FyrBridd/ext_trigger_jbl_sa550/docs/superpowers/plans/2026-11-10-hardware.md

# Dongle Hardware (tooling, schematic, board, fabrication files) Implementation Plan

> **For agentic workers:** REQUIRED SUB-SKILL: Use superpowers:subagent-driven-development (recommended) or superpowers:executing-plans to implement this plan task-by-task. Steps use checkbox (`- [ ]`) syntax for tracking.

**Goal:** Produce a checked KiCad 10 project and JLCPCB fabrication files for the WiiM-trigger-to-RS232 dongle board, entirely from the headless box.

**Architecture:** One Python file (`circuit.py`) is the single source of truth for parts and nets. Scripts generate the schematic (kicad-sch-api) and the board (KiCad's `pcbnew` Python module) from it; nobody hand-writes KiCad file syntax. Every stage is gated by `kicad-cli` checks run through pytest. All tools run in one Docker container.

**Tech Stack:** Docker, `kicad/kicad:10.0` image (KiCad 10.0.8, Python 3.13, `pcbnew`), kicad-sch-api 0.5.5, pytest, `kicad-cli`.

**Spec:** `docs/superpowers/specs/2026-11-10-wiim-trigger-jbl-dongle-design.md` (sections 5, 6, 9 and 10 are the ones this plan implements). Read it before starting.

**Companion plans:** `2026-11-10-firmware.md` (needs only Task 1 of this plan). The enclosure gets its own plan after this one finishes, because it needs the board's 3D model and the owner's cable measurements.

## Global Constraints

- All commands run through `tools/dev <command>` (Task 1). The box has no passwordless sudo; never use sudo.
- KiCad project files under `hardware/dongle/` are generated. Never edit them by hand; change `circuit.py`, `layout.py` or a generator and regenerate.
- Board: 2 layers, 1.6 mm, every assembled part on the top side, ground pour on the bottom.
- Outline: target 12 × 38 mm; hard limits width ≤ 14 mm, length ≤ 45 mm, each side ≥ 10 mm.
- Assembled parts ≥ 1.0 mm from the board edge. Passives are 0603, except the two 10 µF capacitors (0805). Nothing smaller.
- Parts and LCSC numbers exactly as the spec's section 6 table (R1 is 100 Ω, C22775).
- U2 pin 6 (PA0/UPDI) connects only to the programming footprint pad 4 and one test pad.
- Programming footprint pads 1, 5 and 6 are unconnected.
- Every review document is a PDF or Markdown file in the repository; the owner must be able to review the whole design without opening KiCad.
- Done means: ERC zero errors; exported netlist equals `circuit.py`; DRC zero errors, zero unconnected items, schematic parity clean; stock gate passes.
- Commit after each task with the message given. Commit messages end with the line `Co-Authored-By: Claude Fable 5.2 <noreply@anthropic.com>`.

## Review Focus

Failure modes the spec implies that are most likely to cost a board respin:

1. A symbol pin number that does not match the real part's pin (HT7533 pin order, SP3232 charge-pump pins, diode polarity). Pinned by Task 5 (independent datasheet review) and `test_pin_functions` in Task 2.
2. Schematic and board silently disagreeing. Pinned by the netlist-equality test (Task 4) and DRC schematic parity (Task 7).
3. Programming footprint pads in the wrong physical order for the TC2030-MCP-NL cable. Pinned by Task 3's datasheet check and `test_tc2030_pad_positions`.
4. A part placed by JLCPCB rotated 180° (SOT-89, SOIC, TSSOP, diodes). Pinned by `test_cpl_rotations` in Task 8 and the owner's check of JLCPCB's placement preview (Task 10).
5. Wire pads or strain-relief holes too close to the edge or to each other to survive soldering. Pinned by `test_wire_pad_geometry` in Task 3 and `test_edge_clearance` in Task 6.

---

## File structure

```
tools/Dockerfile               dev image: KiCad 10 + Python venv + AVR and host compilers
tools/dev                      wrapper that builds the image if needed and runs a command in it
tools/jlc_stock.py             stock gate (Task 9)
tools/tests/                   pytest for tools
Makefile                       top-level shortcuts
hardware/design/circuit.py     parts and nets: the source of truth
hardware/design/gen_footprints.py  writes the custom footprints
hardware/design/gen_sch.py     circuit.py -> hardware/dongle/dongle.kicad_sch
hardware/design/layout.py      outline, placements, tracks, vias, zones (data only)
hardware/design/gen_pcb.py     circuit.py + layout.py -> hardware/dongle/dongle.kicad_pcb
hardware/design/kicad.py       thin helpers that call kicad-cli and parse its JSON
hardware/design/export_fab.py  Gerbers, drill, BOM, CPL, STEP, renders, PDF
hardware/lib/dongle.pretty/    generated custom footprints
hardware/lib/README.md         datasheet evidence for footprints and pinouts
hardware/dongle/               generated KiCad project (committed)
hardware/fab/                  generated fabrication outputs (committed)
hardware/tests/                pytest for all of the above
docs/hardware-review.md        owner's review pack and ordering steps (Task 10)
```

---

### Task 1: Dev container and repository skeleton

**Files:**
- Create: `tools/Dockerfile`, `tools/dev`, `Makefile`, `.gitignore`, `README.md`, `tools/tests/test_env.py`

**Interfaces:**
- Produces: `tools/dev <cmd...>` runs `<cmd>` inside the image with the repo mounted at `/work` (the working directory), as the caller's uid, with `HOME=/tmp/home`. Image name `dongle-dev`. Inside it: `kicad-cli`, `python` (venv with `pcbnew`, `kicad_sch_api`, `pytest`), `avr-gcc`, `avr-objcopy`, `avr-size`, `gcc`, `make`.

- [ ] **Step 1: Write the failing test** `tools/tests/test_env.py`

```python
import subprocess, shutil

def run(*a): return subprocess.run(a, capture_output=True, text=True, check=True).stdout

def test_kicad_cli_is_10():
    assert run("kicad-cli", "version").strip().startswith("10.0.")

def test_python_modules():
    import pcbnew, kicad_sch_api
    assert pcbnew.Version().startswith("10.0.")
    assert kicad_sch_api.__version__ == "0.5.5"

def test_avr_gcc_knows_attiny412(tmp_path):
    src = tmp_path / "m.c"; src.write_text("#include <avr/io.h>\nint main(void){PORTA.DIRSET=PIN3_bm;for(;;){}}\n")
    run("avr-gcc", "-mmcu=attiny412", "-Os", "-o", str(tmp_path / "m.elf"), str(src))

def test_host_gcc_and_make():
    assert shutil.which("gcc") and shutil.which("make")
```

- [ ] **Step 2: Write `tools/Dockerfile`**

```dockerfile
FROM kicad/kicad:10.0
USER root
RUN apt-get update && apt-get install -y --no-install-recommends \
      python3-pip python3-venv gcc libc6-dev make gcc-avr avr-libc binutils-avr \
    && rm -rf /var/lib/apt/lists/*
RUN python3 -m venv --system-site-packages /opt/venv \
    && /opt/venv/bin/pip install --no-cache-dir kicad-sch-api==0.5.5 pytest
ENV PATH=/opt/venv/bin:$PATH
```

- [ ] **Step 3: Write `tools/dev`** (bash, executable). It runs `docker build -q -t dongle-dev tools/` (cached), then `docker run --rm -u "$(id -u):$(id -g)" -e HOME=/tmp/home -v "<repo root>":/work -w /work dongle-dev "$@"`. Do not use a login shell inside the container; it resets `PATH` and hides the venv.

- [ ] **Step 4: Write `.gitignore`** (`__pycache__/`, `.pytest_cache/`, `*.elf`, `*.o`, `firmware/build/`, `hardware/dongle/*-backups/`, `hardware/dongle/*.lck`, `fp-info-cache`), a `Makefile` with targets `env-test` (`tools/dev pytest tools/tests -q`) and `hw-test` (`tools/dev pytest hardware/tests -q`), and a `README.md` of a few lines: what the project is, a link to the spec, and "run everything through `tools/dev`".

- [ ] **Step 5: Run the test**

Run: `tools/dev pytest tools/tests/test_env.py -q`
Expected: 4 passed. If `test_avr_gcc_knows_attiny412` fails because the image's avr-libc lacks the ATtiny412, stop and report; the fix (a Microchip device pack) needs a decision.

- [ ] **Step 6: Commit** — `chore: dev container and repo skeleton`

---

### Task 2: Circuit definition

**Files:**
- Create: `hardware/design/circuit.py`, `hardware/design/__init__.py`, `hardware/tests/test_circuit.py`

**Interfaces:**
- Produces:
  - `Part` dataclass: `ref: str, value: str, symbol: str, footprint: str, lcsc: str | None, assemble: bool`.
  - `PARTS: dict[str, Part]` keyed by ref.
  - `NETS: dict[str, list[tuple[str, str]]]` mapping net name to `(ref, pin_number)` pairs.
  - `NO_CONNECT: list[tuple[str, str]]`.
  - `PIN_FUNCTIONS: dict[tuple[str, str], str]` giving the datasheet function of every IC pin, for review.

Parts (symbol libraries are KiCad's stock ones; `dongle:` footprints come from Task 3):

| Ref | Value | Symbol | Footprint | LCSC | Assemble |
|---|---|---|---|---|---|
| U1 | HT7533-1 | `Regulator_Linear:HT75xx-1-SOT89` | `Package_TO_SOT_SMD:SOT-89-3` | C14289 | yes |
| U2 | ATtiny412-SSNR | `MCU_Microchip_ATtiny:ATtiny412-SS` | `Package_SO:SOIC-8_3.9x4.9mm_P1.27mm` | C1337190 | yes |
| U3 | SP3232EEY | `Interface_UART:MAX3232` | `Package_SO:TSSOP-16_4.4x5mm_P0.65mm` | C13482 | yes |
| D1 | B5819W | `Device:D_Schottky` | `Diode_SMD:D_SOD-123` | C8598 | yes |
| D2 | SMF15CA | `Device:D_TVS` | `Diode_SMD:D_SOD-123F` | C19077510 | yes |
| D3 | RED | `Device:LED` | `LED_SMD:LED_0603_1608Metric` | C2286 | yes |
| C1, C2 | 10u 25V | `Device:C` | `Capacitor_SMD:C_0805_2012Metric` | C15850 | yes |
| C3–C8 | 100n 50V | `Device:C` | `Capacitor_SMD:C_0603_1608Metric` | C14663 | yes |
| R1 | 100R | `Device:R` | `Resistor_SMD:R_0603_1608Metric` | C22775 | yes |
| R2 | 1k | `Device:R` | same | C21190 | yes |
| R3 | 10k | `Device:R` | same | C25804 | yes |
| J1 | TRIGGER | `Connector_Generic:Conn_01x02` | `dongle:WirePads_1x02_Strain` | — | no |
| J2 | RS232 | `Connector_Generic:Conn_01x03` | `dongle:WirePads_1x03_Strain` | — | no |
| J3 | TC2030 | `Connector_Generic:Conn_01x06` | `dongle:TC2030-MCP-NL` | — | no |
| TP1–TP8 | see nets | `Connector:TestPoint` | `TestPoint:TestPoint_Pad_D1.0mm` | — | no |

Nets (pin numbers are package pin numbers):

| Net | Pins |
|---|---|
| `TRIG_IN` | J1.1, R1.1 |
| `TRIG_R` | R1.2, D2.1, D1.2 (anode) |
| `VIN` | D1.1 (cathode), C1.1, U1.2, TP1.1 |
| `+3V3` | U1.3, C2.1, C3.1, U2.1, U3.16, C8.1, R3.1, J3.2, TP2.1 |
| `GND` | J1.2, D2.2, C1.2, U1.1, C2.2, C3.2, U2.8, U3.15, U3.10, C8.2, C6.2, C7.1, D3.1 (cathode), J2.3, J3.3, TP3.1 |
| `UART_TX` | U2.2, U3.11, R3.2, TP4.1 |
| `UART_RX` | U2.3, U3.12, TP5.1 |
| `RS232_TX` | U3.14, J2.1 |
| `RS232_RX` | U3.13, J2.2 |
| `UPDI` | U2.6, J3.4, TP6.1 |
| `DBG` | U2.4, TP7.1 |
| `SPARE` | U2.5, TP8.1 |
| `LED_DRV` | U2.7, R2.1 |
| `LED_A` | R2.2, D3.2 (anode) |
| `C1P` / `C1M` | U3.1, C4.1 / U3.3, C4.2 |
| `C2P` / `C2M` | U3.4, C5.1 / U3.5, C5.2 |
| `VPOS` | U3.2, C6.1 |
| `VNEG` | U3.6, C7.2 |

`NO_CONNECT`: U3.7, U3.8, U3.9, J3.1, J3.5, J3.6.

- [ ] **Step 1: Write the failing tests** in `hardware/tests/test_circuit.py`

```python
from hardware.design import circuit as c

SPEC_LCSC = {"U1":"C14289","U2":"C1337190","U3":"C13482","D1":"C8598","D2":"C19077510",
             "D3":"C2286","C1":"C15850","C2":"C15850","R1":"C22775","R2":"C21190","R3":"C25804",
             **{f"C{i}":"C14663" for i in range(3, 9)}}

def all_pins(): return [p for pins in c.NETS.values() for p in pins]

def test_lcsc_numbers_match_spec():
    assert {r: p.lcsc for r, p in c.PARTS.items() if p.assemble} == SPEC_LCSC

def test_unassembled_parts_have_no_lcsc():
    assert all(p.lcsc is None for p in c.PARTS.values() if not p.assemble)

def test_no_pin_in_two_nets():
    pins = all_pins() + c.NO_CONNECT
    assert len(pins) == len(set(pins))

def test_every_net_has_two_or_more_pins():
    assert all(len(pins) >= 2 for pins in c.NETS.values())

def test_every_pin_ref_is_a_part():
    assert {r for r, _ in all_pins() + c.NO_CONNECT} <= set(c.PARTS)

def test_ic_pins_fully_accounted_for():
    for ref, n in {"U1": 3, "U2": 8, "U3": 16, "J1": 2, "J2": 3, "J3": 6}.items():
        used = {pin for r, pin in all_pins() + c.NO_CONNECT if r == ref}
        assert used == {str(i) for i in range(1, n + 1)}, ref

def test_updi_only_reaches_programming_pad_and_test_pad():
    assert sorted(c.NETS["UPDI"]) == [("J3", "4"), ("TP6", "1"), ("U2", "6")]

def test_programming_pads_1_5_6_unconnected():
    assert {("J3", "1"), ("J3", "5"), ("J3", "6")} <= set(c.NO_CONNECT)

def test_pin_functions():
    f = c.PIN_FUNCTIONS
    assert f[("U1","1")] == "GND" and f[("U1","2")] == "VIN" and f[("U1","3")] == "VOUT"
    assert f[("U2","1")] == "VDD" and f[("U2","8")] == "GND"
    assert f[("U2","2")] == "PA6/TXD" and f[("U2","3")] == "PA7/RXD" and f[("U2","6")] == "PA0/UPDI"
    assert f[("U3","11")] == "T1IN" and f[("U3","14")] == "T1OUT"
    assert f[("U3","13")] == "R1IN" and f[("U3","12")] == "R1OUT"
    assert f[("U3","16")] == "VCC" and f[("U3","15")] == "GND" and f[("U3","10")] == "T2IN"
```

- [ ] **Step 2: Run** `tools/dev pytest hardware/tests/test_circuit.py -q` — expected: import error.
- [ ] **Step 3: Write `circuit.py`** from the two tables above. `PIN_FUNCTIONS` covers every pin of U1, U2 and U3, typed in from the datasheets (U3: 1 C1+, 2 V+, 3 C1−, 4 C2+, 5 C2−, 6 V−, 7 T2OUT, 8 R2IN, 9 R2OUT, 10 T2IN, 11 T1IN, 12 R1OUT, 13 R1IN, 14 T1OUT, 15 GND, 16 VCC; U2: 1 VDD, 2 PA6/TXD, 3 PA7/RXD, 4 PA1, 5 PA2, 6 PA0/UPDI, 7 PA3, 8 GND).
- [ ] **Step 4: Run** the tests — expected: all pass.
- [ ] **Step 5: Commit** — `feat(hw): circuit definition`

---

### Task 3: Custom footprints

**Files:**
- Create: `hardware/design/gen_footprints.py`, `hardware/lib/README.md`, `hardware/tests/test_footprints.py`
- Generated: `hardware/lib/dongle.pretty/WirePads_1x02_Strain.kicad_mod`, `WirePads_1x03_Strain.kicad_mod`, `TC2030-MCP-NL.kicad_mod`

**Interfaces:**
- Produces: footprint library directory `hardware/lib/dongle.pretty`, nickname `dongle`. `gen_footprints.main()` regenerates it. Run as `python -m hardware.design.gen_footprints`.

Wire pad footprint, for N wires (N = 2 and 3):
- N plated through-hole pads, numbered 1..N, drill 1.0 mm, round copper 1.8 mm, at `(0, i × 2.54)` mm.
- N unplated holes, drill 1.5 mm, at `(-3.0, i × 2.54)` mm. These are the strain-relief holes and sit on the board-end side of the pads.
- Silkscreen pad numbers; courtyard around everything.

TC2030-MCP-NL: start from the stock footprint `Connector:Tag-Connect_TC2030-IDC-NL_2x03_P1.27mm_Vertical` (in `/usr/share/kicad/footprints/Connector.pretty/`). The copper pattern is the same for every TC2030-NL cable; only the pad numbering may differ.

- [ ] **Step 1: Establish the TC2030-MCP-NL pad order.** Fetch the Tag-Connect TC2030-MCP-NL datasheet (try `https://www.tag-connect.com/product/tc2030-mcp-nl-6-pin-no-legs-cable-with-rj12-modular-plug-for-microchip-icd` and the PDF it links, or `https://www.farnell.com/cad/3360979.pdf`). Record in `hardware/lib/README.md`: the URL, and a table giving, for each of the six physical pad positions (as x, y offsets in the stock footprint), the RJ12 pin and Microchip signal (MCLR/VPP, VDD, GND, PGD, PGC, AUX). The spec expects pads 1–6 = MCLR, VDD, GND, PGD, PGC, AUX. **If the datasheet cannot be fetched or contradicts that, stop and ask the owner to buzz out the cable** (RJ12 pin to pogo-pin position); do not guess.
- [ ] **Step 2: Write the failing tests** in `hardware/tests/test_footprints.py`

```python
import pcbnew, pathlib
LIB = str(pathlib.Path("hardware/lib/dongle.pretty").resolve())
mm = pcbnew.ToMM

def load(name): return pcbnew.FootprintLoad(LIB, name)

def test_wire_pad_geometry():
    for n, name in ((2, "WirePads_1x02_Strain"), (3, "WirePads_1x03_Strain")):
        fp = load(name)
        plated = sorted((p for p in fp.Pads() if p.GetAttribute() == pcbnew.PAD_ATTRIB_PTH), key=lambda p: p.GetNumber())
        holes = [p for p in fp.Pads() if p.GetAttribute() == pcbnew.PAD_ATTRIB_NPTH]
        assert [p.GetNumber() for p in plated] == [str(i) for i in range(1, n + 1)]
        assert len(holes) == n
        for i, p in enumerate(plated):
            assert round(mm(p.GetDrillSize().x), 2) == 1.0 and round(mm(p.GetSize().x), 2) == 1.8
            assert round(mm(p.GetPosition().y - plated[0].GetPosition().y), 2) == round(i * 2.54, 2)
        for h in holes:
            assert round(mm(h.GetDrillSize().x), 2) == 1.5
            assert round(mm(h.GetPosition().x - plated[0].GetPosition().x), 2) == -3.0

def test_tc2030_pad_positions():
    stock = pcbnew.FootprintLoad("/usr/share/kicad/footprints/Connector.pretty",
                                 "Tag-Connect_TC2030-IDC-NL_2x03_P1.27mm_Vertical")
    ours = load("TC2030-MCP-NL")
    copper = lambda fp: sorted((mm(p.GetPosition().x), mm(p.GetPosition().y)) for p in fp.Pads() if p.GetNumber())
    assert copper(ours) == copper(stock)                      # same land pattern
    assert sorted(p.GetNumber() for p in ours.Pads() if p.GetNumber()) == list("123456")
    # MCP_PAD_XY in gen_footprints is the table recorded in hardware/lib/README.md
    from hardware.design.gen_footprints import MCP_PAD_XY
    for p in ours.Pads():
        if p.GetNumber():
            assert MCP_PAD_XY[p.GetNumber()] == (round(mm(p.GetPosition().x), 3), round(mm(p.GetPosition().y), 3))
```

- [ ] **Step 3: Run** the tests — expected: fail (library missing).
- [ ] **Step 4: Write `gen_footprints.py`.** Build the wire pad footprints with the `pcbnew` API (`pcbnew.FOOTPRINT`, `pcbnew.PAD`) and save with `pcbnew.FootprintSave`. Build `TC2030-MCP-NL` by loading the stock footprint and renumbering its pads according to `MCP_PAD_XY: dict[str, tuple[float, float]]`, which is typed in from the Step 1 table.
- [ ] **Step 5: Run** `tools/dev python -m hardware.design.gen_footprints` then the tests — expected: pass.
- [ ] **Step 6: Commit** — `feat(hw): wire pad and programming footprints`

---

### Task 4: Schematic generator with ERC and netlist checks

**Files:**
- Create: `hardware/design/gen_sch.py`, `hardware/design/kicad.py`, `hardware/tests/test_schematic.py`
- Generated: `hardware/dongle/dongle.kicad_sch`, `hardware/dongle/dongle.kicad_pro`, `hardware/dongle/fp-lib-table`, `hardware/fab/schematic.pdf`

**Interfaces:**
- Consumes: `circuit.PARTS`, `circuit.NETS`, `circuit.NO_CONNECT`.
- Produces:
  - `gen_sch.main()` writes the project files; run as `python -m hardware.design.gen_sch`.
  - `gen_sch.symbol_uuid(ref: str) -> str`, a deterministic `uuid.uuid5` per reference. Task 6 uses it to link footprints to symbols.
  - `kicad.erc(sch_path) -> list[dict]` (violations with `type`, `severity`, `description`), `kicad.export_netlist(sch_path) -> dict[str, set[tuple[str, str]]]` (net name to pins), `kicad.export_pdf(sch_path, out_path)`.

What the spike on this box already established (kicad-sch-api 0.5.5 with KiCad 10.0.8):
- `sch = kicad_sch_api.create_schematic("dongle")`; `sch.components.add(lib_id, reference=, value=, position=(x, y), footprint=, component_uuid=, **properties)`; extra keyword properties (for example `LCSC="C21190"`) become symbol fields.
- `sch.add_label("NET", pin=("R1", "1"))` attaches a label directly to a pin, and KiCad's ERC treats the pin as connected. Use this for every connection; draw no wires.
- `sch.no_connects.add(...)` places no-connect flags; `sch.get_component_pin_position(ref, pin)` gives a pin's position.
- `sch.save(path)` output loads in `kicad-cli` without errors.

- [ ] **Step 1: Write the failing tests** in `hardware/tests/test_schematic.py`

```python
import pathlib, pytest
from hardware.design import circuit as c, gen_sch, kicad

SCH = pathlib.Path("hardware/dongle/dongle.kicad_sch")

@pytest.fixture(scope="module", autouse=True)
def generated(): gen_sch.main()

def test_erc_has_no_errors():
    errors = [v for v in kicad.erc(SCH) if v["severity"] == "error"]
    assert errors == []

def test_erc_warnings_are_only_allowed_kinds():
    allowed = {"lib_symbol_issues", "lib_symbol_mismatch", "footprint_link_issues"}
    assert {v["type"] for v in kicad.erc(SCH) if v["severity"] == "warning"} <= allowed

def test_exported_netlist_equals_circuit():
    exported = kicad.export_netlist(SCH)
    expected = {name: set(pins) for name, pins in c.NETS.items()}
    named = {n.lstrip("/"): pins for n, pins in exported.items() if not n.startswith("unconnected-")}
    assert named == expected

def test_every_part_has_footprint_and_lcsc_field():
    fields = kicad.symbol_fields(SCH)          # {ref: {"Footprint": ..., "LCSC": ..., "Value": ...}}
    for ref, part in c.PARTS.items():
        assert fields[ref]["Footprint"] == part.footprint
        assert fields[ref].get("LCSC", "") == (part.lcsc or "")

def test_pdf_is_written():
    out = pathlib.Path("hardware/fab/schematic.pdf")
    kicad.export_pdf(SCH, out)
    assert out.stat().st_size > 10_000
```

- [ ] **Step 2: Run** — expected: fail (module missing).
- [ ] **Step 3: Write `kicad.py`.** `erc` runs `kicad-cli sch erc --format json --severity-all -o <tmp> <sch>` and flattens `sheets[].violations[]`. `export_netlist` runs `kicad-cli sch export netlist --format kicadsexpr` and parses the `(nets ...)` section into `{name: {(ref, pin), ...}}`. `symbol_fields` reads the `(components ...)` section of the same netlist. `export_pdf` runs `kicad-cli sch export pdf`.
- [ ] **Step 4: Write `gen_sch.py`.**
  - Place parts on a 2.54 mm grid in four labelled groups, left to right: "Trigger input and 3.3 V supply", "Controller", "RS232 driver", "Programming and test pads". Use `sch.add_text` for the group titles. Leave at least 20 mm between parts so pin labels do not overlap.
  - For every `(ref, pin)` in `NETS`, add a pin label with the net name. For every `NO_CONNECT` pin, add a no-connect flag at the pin position.
  - Add `power:PWR_FLAG` symbols labelled onto `GND` and `VIN` so ERC sees those nets as driven.
  - Pass `component_uuid=symbol_uuid(ref)` for every part.
  - Write `dongle.kicad_pro` (minimal valid project JSON) and `fp-lib-table` containing the `dongle` library as `${KIPRJMOD}/../lib/dongle.pretty`.
- [ ] **Step 5: Run** `tools/dev pytest hardware/tests/test_schematic.py -q` — expected: all pass. If a warning type outside the allow-list appears, fix its cause; widen the allow-list only for a warning that is cosmetic, and say why in a comment.
- [ ] **Step 6: Look at the result.** Convert page 1 of `hardware/fab/schematic.pdf` to PNG (`tools/dev kicad-cli sch export svg` or `pdftoppm` if present) and view it. Fix overlapping labels or parts by moving placements. The owner will read this drawing.
- [ ] **Step 7: Commit** — `feat(hw): generated schematic with ERC and netlist checks`

---

### Task 5: Independent datasheet review of the circuit

**Files:**
- Create: `docs/hardware-datasheet-review.md`
- Modify: `hardware/design/circuit.py` and `hardware/lib/README.md` only if the review finds an error

**Interfaces:**
- Consumes: `circuit.py`, `hardware/fab/schematic.pdf`, spec section 5.

This task is a check by someone who did not write `circuit.py`. Dispatch a fresh reviewer (a subagent with no prior context) with this brief:

> Review `hardware/design/circuit.py` against manufacturer datasheets you fetch yourself. For each of U1 (Holtek HT7533-1, SOT-89), U2 (Microchip ATtiny412, SOIC-8), U3 (MaxLinear SP3232EEY, TSSOP-16), D1 (B5819W, SOD-123), D2 (SMF15CA, SOD-123FL), D3 (KT-0603R): confirm every pin number in `PIN_FUNCTIONS` and `NETS` matches the datasheet's pin function for that exact package; confirm KiCad's stock symbol and footprint named in `PARTS` number their pins and pads the same way as the datasheet (open the files under `/usr/share/kicad/` via `tools/dev`); confirm diode polarity (which pad is the cathode); confirm no part exceeds its ratings at 12 V nominal input with a 24.4 V TVS clamp. Also confirm the SP3232EEY's capacitor connections and values for 3.3 V operation, and that tying T2IN to ground and leaving R2IN open is acceptable. Write `docs/hardware-datasheet-review.md` with one row per check: what was checked, the datasheet URL and page, and pass or fail. Do not change any other file.

- [ ] **Step 1: Dispatch the reviewer** with the brief above.
- [ ] **Step 2: Fix every failed row** in `circuit.py`, rerun `tools/dev pytest hardware/tests -q`, and update the review file to show the fix.
- [ ] **Step 3: Commit** — `docs(hw): independent datasheet review`

---

### Task 6: Board outline and placement

**Files:**
- Create: `hardware/design/layout.py`, `hardware/design/gen_pcb.py`, `hardware/tests/test_board.py`
- Modify: `hardware/design/kicad.py` (add `render`)
- Generated: `hardware/dongle/dongle.kicad_pcb`, `hardware/fab/board-top.png`, `hardware/fab/board-bottom.png`

**Interfaces:**
- Consumes: `circuit.PARTS`, `circuit.NETS`, `gen_sch.symbol_uuid`, the footprint libraries.
- Produces:
  - `layout.OUTLINE = (width_mm, length_mm)`; `layout.PLACEMENTS: dict[str, tuple[float, float, float]]` (ref to x, y, rotation in degrees; origin at the board's top-left corner, x along the length); `layout.TRACKS`, `layout.VIAS` (empty until Task 7).
  - `gen_pcb.main()` writes the board; run as `python -m hardware.design.gen_pcb`.
  - `kicad.render(pcb_path, out_png, side)` using `kicad-cli pcb render`.

Floorplan, along the length from the trigger end to the amp end:
1. J1 with its strain-relief holes at the board end.
2. R1, D2, D1, C1, U1, C2 (the supply).
3. U2 with C3 beside pin 1; D3 and R2.
4. J3 (programming footprint), with no copper or parts on the bottom side behind it, and its alignment holes clear.
5. U3 with C4–C8 close to their pins, and R3.
6. J2 with its strain-relief holes at the other board end.

Test pads TP1–TP8 go on the top side wherever they fit, each with a silkscreen label (`VIN`, `3V3`, `GND`, `TXL`, `RXL`, `UPDI`, `PA1`, `PA2`). Silkscreen also labels J1 pads `+12V` and `GND`, and J2 pads `TX→2`, `RX←3`, `GND 5` (the DB9 pin each goes to), plus a board name and revision `r1`.

Non-obvious `pcbnew` points:
- Create nets with `pcbnew.NETINFO_ITEM(board, name)` and `board.Add(net)`; assign with `pad.SetNet(net)`.
- For schematic parity, each footprint needs `fp.SetPath(pcbnew.KIID_PATH("/" + gen_sch.symbol_uuid(ref)))`, the same reference and value as the symbol, and its library id set (`fp.SetFPID(pcbnew.LIB_ID(lib_nickname, name))`).
- Mark J1, J2, J3 and TP* as excluded from position files and from the BOM (`fp.SetAttributes(... | pcbnew.FP_EXCLUDE_FROM_POS_FILES | pcbnew.FP_EXCLUDE_FROM_BOM)`).
- The outline is four `PCB_SHAPE` segments on `Edge.Cuts`.

- [ ] **Step 1: Write the failing tests** in `hardware/tests/test_board.py`

```python
import pathlib, pcbnew, pytest
from hardware.design import circuit as c, gen_pcb, layout

PCB = pathlib.Path("hardware/dongle/dongle.kicad_pcb")
mm = pcbnew.ToMM

@pytest.fixture(scope="module")
def board():
    gen_pcb.main()
    return pcbnew.LoadBoard(str(PCB))

def test_outline_within_limits(board):
    bb = board.GetBoardEdgesBoundingBox()
    w, l = sorted((mm(bb.GetWidth()), mm(bb.GetHeight())))
    assert 10.0 <= w <= 14.0 and 10.0 <= l <= 45.0

def test_all_parts_present_with_right_footprint(board):
    got = {fp.GetReference(): str(fp.GetFPID().GetUniStringLibId()) for fp in board.GetFootprints()}
    assert got == {r: p.footprint for r, p in c.PARTS.items()}

def test_assembled_parts_on_top(board):
    for fp in board.GetFootprints():
        if c.PARTS[fp.GetReference()].assemble:
            assert fp.GetLayer() == pcbnew.F_Cu, fp.GetReference()

def test_edge_clearance(board):
    edge = board.GetBoardEdgesBoundingBox()
    for fp in board.GetFootprints():
        ref = fp.GetReference()
        box = fp.GetBoundingBox(False)          # pads and body, no text
        margin = 1.0 if c.PARTS[ref].assemble else 0.9   # 0.9: strain holes leave a 1 mm web
        assert mm(box.GetLeft() - edge.GetLeft()) >= margin, ref
        assert mm(edge.GetRight() - box.GetRight()) >= margin, ref
        assert mm(box.GetTop() - edge.GetTop()) >= margin, ref
        assert mm(edge.GetBottom() - box.GetBottom()) >= margin, ref

def test_pad_nets_match_circuit(board):
    got = {}
    for fp in board.GetFootprints():
        for pad in fp.Pads():
            if pad.GetNumber() and pad.GetNetname():
                got.setdefault(pad.GetNetname(), set()).add((fp.GetReference(), pad.GetNumber()))
    assert got == {n: set(p) for n, p in c.NETS.items()}

def test_no_courtyard_overlap(board):
    from hardware.design import kicad
    kinds = {v["type"] for v in kicad.drc(PCB)["violations"]}
    assert "courtyards_overlap" not in kinds

def test_nothing_behind_programming_footprint(board):
    j3 = board.FindFootprintByReference("J3").GetBoundingBox(False)
    for fp in board.GetFootprints():
        if fp.GetLayer() == pcbnew.B_Cu:
            assert not fp.GetBoundingBox(False).Intersects(j3), fp.GetReference()
```

- [ ] **Step 2: Run** — expected: fail (module missing).
- [ ] **Step 3: Add `kicad.drc(pcb_path, parity=False) -> dict`** (runs `kicad-cli pcb drc --format json --severity-all [--schematic-parity] -o <tmp> <pcb>` and returns the parsed JSON, which has `violations`, `unconnected_items` and `schematic_parity` lists) and `kicad.render`.
- [ ] **Step 4: Write `layout.py` and `gen_pcb.py`** following the floorplan. Set the board's design rules in the generator: minimum clearance 0.15 mm, minimum track 0.15 mm, via 0.6 mm with 0.3 mm drill, copper-to-edge 0.3 mm, hole-to-hole 0.5 mm.
- [ ] **Step 5: Run** `tools/dev pytest hardware/tests/test_board.py -q` — expected: all pass.
- [ ] **Step 6: Look at the result.** Render top and bottom to `hardware/fab/board-*.png` and view both. Check the floorplan order, that decoupling capacitors sit by their pins, and that silkscreen labels are readable and not on pads. Adjust `layout.py` and repeat.
- [ ] **Step 7: Commit** — `feat(hw): board outline and placement`

---

### Task 7: Routing, ground pour and clean DRC

**Files:**
- Modify: `hardware/design/layout.py` (fill `TRACKS`, `VIAS`, zones), `hardware/design/gen_pcb.py`, `hardware/tests/test_board.py`

**Interfaces:**
- Consumes: Task 6's board.
- Produces: `layout.TRACKS: list[tuple[str, str, float, list[tuple[float, float]]]]` (net, layer `"F.Cu"`/`"B.Cu"`, width mm, points); `layout.VIAS: list[tuple[str, float, float]]` (net, x, y); a fully routed, DRC-clean board.

Rules:
- Track width 0.4 mm for `TRIG_IN`, `TRIG_R`, `VIN`, `+3V3` and any `GND` track; 0.25 mm for everything else.
- `GND` zone covering the whole bottom layer, and a `GND` zone on the top layer; thermal reliefs on the J1 and J2 ground pads so they can be hand-soldered.
- No copper on the bottom layer behind J3 other than the ground pour being cut back; no vias inside J3's bounding box.
- Keep the charge-pump capacitor loops (C4, C5) short.
- Fill zones in the generator (`pcbnew.ZONE_FILLER(board).Fill(board.Zones())`) before saving.

Routing is done by writing track points into `layout.py`, regenerating, running DRC, and viewing a render; repeat until clean. If scripted routing has not converged after a sustained effort, Freerouting's native command-line build (v2.5.0, DSN in, SES out, `--router.copperToEdgeClearanceUm=500`) may be used instead; record which was used in `hardware/lib/README.md`.

- [ ] **Step 1: Add the failing tests** to `hardware/tests/test_board.py`

```python
def test_drc_clean_with_schematic_parity(board):
    from hardware.design import kicad
    r = kicad.drc(PCB, parity=True)
    assert [v for v in r["violations"] if v["severity"] == "error"] == []
    assert r["unconnected_items"] == []
    assert r["schematic_parity"] == []

def test_drc_warnings_are_only_allowed_kinds(board):
    from hardware.design import kicad
    allowed = {"silk_overlap", "silk_over_copper", "lib_footprint_mismatch", "lib_footprint_issues"}
    assert {v["type"] for v in kicad.drc(PCB)["violations"] if v["severity"] == "warning"} <= allowed

def test_power_tracks_are_wide(board):
    wide = {"TRIG_IN", "TRIG_R", "VIN", "+3V3", "GND"}
    for t in board.GetTracks():
        if t.GetClass() == "PCB_TRACK" and t.GetNetname() in wide:
            assert mm(t.GetWidth()) >= 0.4, t.GetNetname()

def test_no_vias_in_programming_footprint(board):
    j3 = board.FindFootprintByReference("J3").GetBoundingBox(False)
    assert not any(t.GetClass() == "PCB_VIA" and j3.Contains(t.GetPosition()) for t in board.GetTracks())
```

- [ ] **Step 2: Run** — expected: `test_drc_clean_with_schematic_parity` fails with unconnected items.
- [ ] **Step 3: Route** as described until all tests in `hardware/tests` pass.

Run: `tools/dev pytest hardware/tests -q`
Expected: all pass.

- [ ] **Step 4: Look at the result.** Render both sides and view them. Check there are no acute-angle or needlessly long tracks, and that the ground pour is continuous under U3 and U2.
- [ ] **Step 5: Commit** — `feat(hw): routed board, DRC clean with schematic parity`

---

### Task 8: Fabrication outputs

**Files:**
- Create: `hardware/design/export_fab.py`, `hardware/tests/test_fab.py`
- Generated in `hardware/fab/`: `gerbers.zip`, `bom.csv`, `cpl.csv`, `dongle.step`, `board-top.png`, `board-bottom.png`, `schematic.pdf`

**Interfaces:**
- Consumes: the board and schematic; `circuit.PARTS`.
- Produces: `export_fab.main()`; run as `python -m hardware.design.export_fab`. `export_fab.ROTATION_OFFSETS: dict[str, int]` (footprint-name regex to degrees added to KiCad's rotation for JLCPCB).

Formats:
- `bom.csv` header exactly `Comment,Designator,Footprint,LCSC Part #`; one row per distinct LCSC number among assembled parts, designators comma-joined inside one quoted cell, built from `circuit.PARTS`.
- `cpl.csv` header exactly `Designator,Mid X,Mid Y,Layer,Rotation`; one row per assembled part; `Layer` is `Top`; positions in mm from `kicad-cli pcb export pos --format csv --units mm --side front`; rotation = (KiCad rotation + offset) mod 360.
- `ROTATION_OFFSETS`, from the community JLCPCB rotation tables: `^SOT-89` 180, `^SOIC-` 270, `^TSSOP-` 270, everything else 0. These are checked by the owner in JLCPCB's placement preview (Task 10); they are a best starting point, not verified fact.
- `gerbers.zip` holds Gerbers for F.Cu, B.Cu, F.Mask, B.Mask, F.Paste, F.SilkS, B.SilkS, Edge.Cuts and Excellon drill files (plated and unplated), exported with `kicad-cli pcb export gerbers` and `kicad-cli pcb export drill`.
- `dongle.step` from `kicad-cli pcb export step` with component models; the enclosure plan uses it.
- `board.pdf` from `kicad-cli pcb export pdf`, one page per view, each including Edge.Cuts: (1) F.Cu + F.SilkS + F.Fab, (2) B.Cu + B.SilkS, (3) Edge.Cuts + User.Drawings + F.Fab, where `gen_pcb` puts overall width and length dimensions and the hole positions on User.Drawings. This is the owner's board drawing; they will not open KiCad.

- [ ] **Step 1: Write the failing tests** in `hardware/tests/test_fab.py`

```python
import csv, pathlib, zipfile, pytest
from hardware.design import circuit as c, export_fab

FAB = pathlib.Path("hardware/fab")

@pytest.fixture(scope="module", autouse=True)
def exported(): export_fab.main()

def rows(name): return list(csv.DictReader((FAB / name).open()))

def test_bom_matches_circuit():
    bom = rows("bom.csv")
    assert list(bom[0]) == ["Comment", "Designator", "Footprint", "LCSC Part #"]
    got = {r["LCSC Part #"]: set(r["Designator"].split(",")) for r in bom}
    want = {}
    for ref, p in c.PARTS.items():
        if p.assemble: want.setdefault(p.lcsc, set()).add(ref)
    assert got == want

def test_cpl_lists_exactly_the_assembled_parts():
    cpl = rows("cpl.csv")
    assert list(cpl[0]) == ["Designator", "Mid X", "Mid Y", "Layer", "Rotation"]
    assert {r["Designator"] for r in cpl} == {r for r, p in c.PARTS.items() if p.assemble}
    assert {r["Layer"] for r in cpl} == {"Top"}

def test_cpl_rotations():
    import pcbnew
    board = pcbnew.LoadBoard("hardware/dongle/dongle.kicad_pcb")
    cpl = {r["Designator"]: float(r["Rotation"]) for r in rows("cpl.csv")}
    for ref, offset in (("U1", 180), ("U2", 270), ("U3", 270), ("R1", 0), ("D1", 0)):
        kicad_rot = board.FindFootprintByReference(ref).GetOrientationDegrees()
        assert cpl[ref] == (kicad_rot + offset) % 360, ref

def test_gerber_zip_has_all_layers():
    names = " ".join(zipfile.ZipFile(FAB / "gerbers.zip").namelist())
    for token in ("F_Cu", "B_Cu", "F_Mask", "B_Mask", "F_Paste", "F_Silkscreen", "B_Silkscreen", "Edge_Cuts", ".drl"):
        assert token in names, token

def test_step_written():
    assert (FAB / "dongle.step").stat().st_size > 50_000

def test_board_pdf_has_three_pages():
    data = (FAB / "board.pdf").read_bytes()
    assert data.startswith(b"%PDF") and data.count(b"/Type /Page") - data.count(b"/Type /Pages") == 3
```

- [ ] **Step 2: Run** — expected: fail (module missing).
- [ ] **Step 3: Write `export_fab.py`.**
- [ ] **Step 4: Run** `tools/dev pytest hardware/tests -q` — expected: all pass. If KiCad names a Gerber layer differently from the tokens in `test_gerber_zip_has_all_layers`, correct the tokens to KiCad 10's actual file names.
- [ ] **Step 5: Add `make hw`** (footprints, schematic, board, fab, in order) and `make hw-test` to the `Makefile`.
- [ ] **Step 6: Commit** — `feat(hw): JLCPCB fabrication outputs`

---

### Task 9: Stock gate

**Files:**
- Create: `tools/jlc_stock.py`, `tools/tests/test_jlc_stock.py`, `tools/tests/fixtures/jlc_C1337190.json`
- Generated: `hardware/fab/stock-report.md`

**Interfaces:**
- Consumes: `hardware/fab/bom.csv`.
- Produces: `python tools/jlc_stock.py --bom hardware/fab/bom.csv [--min-stock 200] [--report hardware/fab/stock-report.md]`. Exit status 0 when every BOM part is found with stock ≥ `--min-stock`; 1 otherwise; 2 when the API could not be reached or its reply could not be understood. Functions: `parse_component(api_json: dict, lcsc: str) -> Component | None` with fields `lcsc, model, package, library_type, preferred, stock`; `fetch(lcsc: str) -> dict`; `check(bom_rows, fetcher, min_stock) -> list[Result]`.

The API (unofficial; it worked on 2026-11-10): `POST https://jlcpcb.com/api/overseas-pcb-order/v1/shoppingCart/smtGood/selectSmtComponentList`, JSON body `{"keyword": "<LCSC>", "currentPage": 1, "pageSize": 25}`, headers `Content-Type: application/json` and a generic browser `User-Agent`. The reply's `data.componentPageInfo.list[]` has `componentCode`, `componentModelEn`, `componentSpecificationEn`, `componentLibraryType` (`base` or `expand`), `preferredComponentFlag`, `stockCount`. Match on `componentCode == <LCSC>` exactly; the list also contains near-matches. Send nothing that identifies the owner.

The report also lists the two alternate controllers, for information only: ATtiny402-SSNR `C616056` and ATtiny202-SSNR `C2052951`.

- [ ] **Step 1: Capture a fixture.** Save one real reply for `C1337190` to `tools/tests/fixtures/jlc_C1337190.json`.
- [ ] **Step 2: Write the failing tests** in `tools/tests/test_jlc_stock.py`

```python
import json, pathlib
from tools import jlc_stock as j

FIX = json.loads((pathlib.Path(__file__).parent / "fixtures/jlc_C1337190.json").read_text())

def test_parse_exact_match():
    comp = j.parse_component(FIX, "C1337190")
    assert comp.model == "ATTINY412-SSNR" and comp.package == "SOIC-8"
    assert comp.library_type == "expand" and comp.stock > 0

def test_parse_ignores_near_matches():
    assert j.parse_component(FIX, "C133719") is None

def bom(*codes): return [{"LCSC Part #": c, "Designator": "X1"} for c in codes]

def test_check_passes_and_fails_on_threshold():
    fetcher = lambda code: {"data": {"componentPageInfo": {"list": [
        {"componentCode": code, "componentModelEn": "M", "componentSpecificationEn": "P",
         "componentLibraryType": "base", "preferredComponentFlag": False, "stockCount": 150}]}}}
    assert all(r.ok for r in j.check(bom("C1"), fetcher, min_stock=100))
    assert not any(r.ok for r in j.check(bom("C1"), fetcher, min_stock=200))

def test_check_fails_when_part_missing():
    fetcher = lambda code: {"data": {"componentPageInfo": {"list": []}}}
    assert [r.ok for r in j.check(bom("C1"), fetcher, min_stock=1)] == [False]

def test_malformed_reply_is_an_api_error():
    import pytest
    with pytest.raises(j.ApiError):
        j.check(bom("C1"), lambda code: {"code": 500}, min_stock=1)
```

- [ ] **Step 3: Run** — expected: fail (module missing).
- [ ] **Step 4: Write `tools/jlc_stock.py`** using only the Python standard library.
- [ ] **Step 5: Run** `tools/dev pytest tools/tests -q` — expected: all pass.
- [ ] **Step 6: Run the gate for real.**

Run: `tools/dev python tools/jlc_stock.py --bom hardware/fab/bom.csv --report hardware/fab/stock-report.md`
Expected: exit 0 and a table with every part in stock. If it exits 1, stop and report which part; do not substitute a part without the owner.

- [ ] **Step 7: Add `make stock`** and commit — `feat(tools): JLCPCB stock gate`

---

### Task 10: Owner's review pack

**Files:**
- Create: `docs/hardware-review.md`, `docs/hardware-calculations.md`

**Interfaces:**
- Consumes: everything in `hardware/fab/`, `docs/hardware-datasheet-review.md`.

- [ ] **Step 0: Write `docs/hardware-calculations.md`**, each item showing the formula, the inputs with their source (datasheet value or spec), and the result against its limit: supply current budget against the trigger's 220 mA; voltage at the regulator input after R1 and D1, against the regulator's dropout; regulator dissipation; inrush peak through R1; R1 dissipation; TVS clamp voltage against the regulator's and C1's ratings; LED current; serial baud divisor and error, with the oscillator tolerance; RS232 output swing at 3.3 V; capacitor voltage ratings against what they see; and track current capacity for the widths used. Values taken from memory and not from a fetched datasheet are marked as such.
- [ ] **Step 1: Write `docs/hardware-review.md`** containing, in this order:
  1. What to read, all PDF or Markdown: `hardware/fab/schematic.pdf`; `hardware/fab/board.pdf`; the two board renders, embedded as images in this file; `docs/hardware-calculations.md`; `docs/hardware-datasheet-review.md`. Opening `hardware/dongle/dongle.kicad_pro` in KiCad 10 is optional.
  2. A checklist for the owner: schematic reads as intended; wire pads and their labels; programming footprint is reachable and matches the TC2030-MCP-NL; test pad labels; board size.
  3. Results of the automated gates, with the commands to rerun them (`make hw-test`, `make stock`).
  4. Ordering steps for JLCPCB: upload `gerbers.zip`; 2 layers, 1.6 mm, quantity 5; PCB assembly, economic, top side, 2 assembled; upload `bom.csv` and `cpl.csv`; **in the placement preview, check the pin-1 dot of U1, U2 and U3 and the cathode mark of D1, D2 and D3 against the silkscreen**, and correct any rotation there; run `make stock` again on the day.
  5. The controller stock position and the two alternates, and the suggestion to buy the controllers into the JLCPCB parts library now if the owner's account offers that.
  6. Every `[verify]` item from the spec that concerns the board, with its current status.
- [ ] **Step 2: Run the full suite one last time.**

Run: `tools/dev pytest tools/tests hardware/tests -q`
Expected: all pass.

- [ ] **Step 3: Commit** — `docs(hw): owner review pack and ordering steps`
- [ ] **Step 4: Stop and hand over to the owner** for the visual review. Do not present the board as ready to order until they have looked at it.
