FyrBridd/ext_trigger_jbl_sa550/docs/superpowers/plans/2026-11-10-firmware.md

# Dongle Firmware Implementation Plan

> **For agentic workers:** REQUIRED SUB-SKILL: Use superpowers:subagent-driven-development (recommended) or superpowers:executing-plans to implement this plan task-by-task. Steps use checkbox (`- [ ]`) syntax for tracking.

**Goal:** Firmware for the ATtiny412 dongle that keeps a JBL SA550 switched on and on its STB input over RS232, proven against a simulated amp on the Linux box and shipped as ready-to-flash hex files with a written bring-up procedure.

**Architecture:** Plain C in three hardware-free modules (frame protocol, controller state machine, command table) glued by a small `app` loop that talks to a hardware interface (`hal.h`). On the host, the same `app` is linked against a fake hardware layer and a simulated amp, so whole scenarios run under a virtual clock. On the AVR, `hal_avr.c` is the only file touching registers.

**Tech Stack:** C11, avr-gcc and avr-libc (ATtiny412), host gcc, make, Python 3 (two small build-check and decode tools), pytest. Everything runs through `tools/dev`.

**Spec:** `docs/superpowers/specs/2026-11-10-wiim-trigger-jbl-dongle-design.md` (sections 3.2, 7 and 11). Read it before starting.

**Prerequisite:** Task 1 of `2026-11-10-hardware.md` (the dev container and `tools/dev`).

## Global Constraints

- No Arduino framework; no dynamic memory; no floating point.
- Target ATtiny412 at 3.3 V on the internal oscillator: `F_CPU=3333333UL`. Serial is 38,400 baud, 8N1.
- Pins: PA6 USART transmit, PA7 USART receive, PA3 LED (high = on), PA1 debug trace output, PA0 UPDI (never reconfigured).
- Every build variant must fit 4096 bytes of flash and 256 bytes of RAM (ATtiny412 and ATtiny402). The default release variant should also be reported against 2048 bytes (ATtiny202); exceeding that is not a failure.
- The firmware never sends power-off, volume, or processor-mode commands.
- All timings are named constants in `firmware/src/config.h`, overridable with `-D`.
- Compiler flags for both host and AVR: `-std=c11 -Wall -Wextra -Werror`.
- Fuses must leave PA0 as UPDI (`SYSCFG0` bits 3:2 = `01`).
- Commit after each task with the message given. Commit messages end with the line `Co-Authored-By: Claude Fable 5.2 <noreply@anthropic.com>`.

## Review Focus

Conditions the spec implies that are most likely to bite on the real amp:

1. **Reply data that looks like framing.** A data byte equal to `21` or `0D` inside a frame must not split or end it. Pinned by `test_data_bytes_that_look_like_framing` (Task 1).
2. **Millisecond counter wrap-around.** The 16-bit counter wraps every 65.5 s; the dongle runs for hours. Pinned by `test_wraparound` (Task 3) and `scenario_long_run_crosses_wrap` (Task 4).
3. **Unsolicited frames arriving between a query and its reply.** The amp may announce a front-panel change at any moment. Pinned by `test_unsolicited_frame_while_awaiting` (Task 3).
4. **An amp that is silent, then starts answering** (booting, or "RS232 Stdby" off and switched on by hand). Pinned by `scenario_silent_then_switched_on_by_hand` (Task 4).
5. **Line noise and truncated frames at power-up.** Pinned by `test_garbage_and_truncated_frames` (Task 1) and `scenario_noise_on_the_line` (Task 4).

---

## File structure

```
firmware/Makefile            host tests, AVR builds, variant matrix, size and fuse gates
firmware/src/config.h        timings and build options
firmware/src/proto.h/.c      frame builder and byte-stream parser (pure)
firmware/src/cmds.h/.c       command bytes for each action and variant (pure)
firmware/src/ctrl.h/.c       controller state machine (pure)
firmware/src/dbglog.h/.c     EEPROM reply log, debug builds only (uses hal EEPROM calls)
firmware/src/app.h/.c        the loop body: hal <-> proto <-> ctrl, LED, debug hooks
firmware/src/hal.h           hardware interface
firmware/src/hal_avr.c       ATtiny412 implementation
firmware/src/main.c          fuses and main()
firmware/test/test.h         tiny test harness
firmware/test/sim_amp.h/.c   simulated amplifier
firmware/test/hal_host.h/.c  fake hardware: virtual clock, byte pipes to sim_amp, fake EEPROM
firmware/test/test_*.c       unit and scenario tests
firmware/release/            built hex files (committed)
firmware/FUSES.md            fuse values and why
tools/check_fuses.py         refuses a hex whose fuses would disable UPDI
tools/decode_eeprom.py       prints the debug log from an EEPROM dump
docs/research.md             protocol findings and sources
docs/flashing.md             how to flash and read back
docs/bring-up.md             the written procedure for the owner
```

Shared types used across tasks (defined in the task noted):

```c
/* proto.h (Task 1) */
#define PROTO_MAX_DATA 8
typedef struct { uint8_t zone, cmd, answer, len; uint8_t data[PROTO_MAX_DATA]; } proto_frame_t;

/* ctrl.h (Task 3) */
typedef enum { SEND_NONE = 0, SEND_POWER_QUERY, SEND_POWER_ON, SEND_INPUT_QUERY, SEND_SELECT_STB } ctrl_send_t;
typedef enum { LED_FAST = 0, LED_SLOW, LED_SOLID } ctrl_led_t;
```

`config.h` values (Task 1 creates the file; each wrapped in `#ifndef`):

| Name | Value | Meaning |
|---|---|---|
| `STARTUP_MS` | 50 | wait for the serial driver's charge pump |
| `POLL_MS` | 2000 | re-check interval once the amp is on and on STB |
| `WAKE_POLL_MS` | 500 | re-check interval while it is not |
| `REPLY_TIMEOUT_MS` | 1000 | how long to wait for a query's reply |
| `SETTLE_MS` | 1500 | pause after the amp first reports on |
| `PARSER_GAP_MS` | 50 | silence that abandons a half-received frame |
| `INPUT_STB` | 0x05 | STB input code |
| `CFG_POWER_RC5` | 0 | 1 = send power-on as a simulated remote code |
| `CFG_INPUT_RC5` | 0 | 1 = send select-STB as a simulated remote code |
| `CFG_INPUT_QUERY` | 1 | 0 = never query the input (see Task 3) |
| `CFG_DEBUG` | 0 | 1 = live trace and EEPROM log |

---

### Task 1: Test harness and frame protocol

**Files:**
- Create: `firmware/Makefile`, `firmware/src/config.h`, `firmware/src/proto.h`, `firmware/src/proto.c`, `firmware/test/test.h`, `firmware/test/test_proto.c`

**Interfaces:**
- Produces:
  - `uint8_t proto_build(uint8_t *buf, uint8_t cmd, const uint8_t *data, uint8_t len);` writes `21 01 <cmd> <len> <data...> 0D`, returns the frame length (`len + 5`).
  - `typedef struct proto_parser proto_parser_t;` (complete type in the header so it can live on the stack or in static storage).
  - `void proto_parser_init(proto_parser_t *p);`
  - `bool proto_parser_feed(proto_parser_t *p, uint8_t byte, proto_frame_t *out);` returns true exactly when `byte` completes a valid response frame, which is copied to `*out`.
  - `bool proto_parser_busy(const proto_parser_t *p);` true when part-way through a frame.
  - `make -C firmware test` builds and runs every host test binary and fails if any test fails.

Parser rules. A response is `21 <zone> <cmd> <answer> <len> <data × len> 0D`. Bytes before `21` are skipped. The frame's extent is decided by `<len>`, never by searching for `0D`. If the byte after the data is not `0D`, or `<len>` exceeds `PROTO_MAX_DATA`, the frame is dropped and the parser returns to hunting for `21`, starting with the next byte.

- [ ] **Step 1: Write `firmware/test/test.h`**

```c
#ifndef TEST_H
#define TEST_H
#include <stdio.h>
#include <string.h>
#include <stdint.h>
#include <stdbool.h>
static int t_fail, t_run;
#define CHECK(c) do { t_run++; if (!(c)) { t_fail++; printf("  FAIL %s:%d: %s\n", __FILE__, __LINE__, #c); } } while (0)
#define CHECK_EQ(a, b) do { long _a = (long)(a), _b = (long)(b); t_run++; \
  if (_a != _b) { t_fail++; printf("  FAIL %s:%d: %s == %s (%ld vs %ld)\n", __FILE__, __LINE__, #a, #b, _a, _b); } } while (0)
/* parse "21 01 00" into bytes; returns count */
static inline uint8_t hex(const char *s, uint8_t *out) { uint8_t n = 0; unsigned v;
  while (sscanf(s, "%x", &v) == 1) { out[n++] = (uint8_t)v; while (*s && *s != ' ') s++; while (*s == ' ') s++; } return n; }
#define CHECK_HEX(buf, n, str) do { uint8_t _e[64]; uint8_t _n = hex(str, _e); CHECK_EQ(n, _n); CHECK(memcmp(buf, _e, _n) == 0); } while (0)
#define RUN(fn) do { printf("%s\n", #fn); fn(); } while (0)
#define TEST_MAIN_END() do { printf("%d checks, %d failed\n", t_run, t_fail); return t_fail ? 1 : 0; } while (0)
#endif
```

- [ ] **Step 2: Write the failing tests** in `firmware/test/test_proto.c`

```c
#include "test.h"
#include "proto.h"

static proto_parser_t p; static proto_frame_t f;
/* feed a hex string; return how many frames completed; last one left in f */
static int feed(const char *s) { uint8_t b[64]; uint8_t n = hex(s, b); int got = 0;
  for (uint8_t i = 0; i < n; i++) got += proto_parser_feed(&p, b[i], &f); return got; }

static void test_build_commands(void) {
  uint8_t b[16], d;
  d = 0xF0; CHECK_HEX(b, proto_build(b, 0x00, &d, 1), "21 01 00 01 F0 0D");
  d = 0x05; CHECK_HEX(b, proto_build(b, 0x1D, &d, 1), "21 01 1D 01 05 0D");
  uint8_t rc5[2] = {0x10, 0x7B}; CHECK_HEX(b, proto_build(b, 0x08, rc5, 2), "21 01 08 02 10 7B 0D");
}
static void test_parse_power_reply(void) {
  proto_parser_init(&p);
  CHECK_EQ(feed("21 01 00 00 01 01 0D"), 1);
  CHECK_EQ(f.zone, 1); CHECK_EQ(f.cmd, 0x00); CHECK_EQ(f.answer, 0x00); CHECK_EQ(f.len, 1); CHECK_EQ(f.data[0], 0x01);
  CHECK(!proto_parser_busy(&p));
}
static void test_parse_error_answer_and_zero_length(void) {
  proto_parser_init(&p);
  CHECK_EQ(feed("21 01 1D 85 00 0D"), 1); CHECK_EQ(f.answer, 0x85); CHECK_EQ(f.len, 0);
}
static void test_data_bytes_that_look_like_framing(void) {
  proto_parser_init(&p);
  CHECK_EQ(feed("21 01 08 00 02 0D 21 0D"), 1);
  CHECK_EQ(f.cmd, 0x08); CHECK_EQ(f.len, 2); CHECK_EQ(f.data[0], 0x0D); CHECK_EQ(f.data[1], 0x21);
}
static void test_back_to_back_frames(void) {
  proto_parser_init(&p);
  CHECK_EQ(feed("21 01 00 00 01 01 0D 21 01 1D 00 01 15 0D"), 2);
  CHECK_EQ(f.cmd, 0x1D); CHECK_EQ(f.data[0], 0x15);
}
static void test_garbage_and_truncated_frames(void) {
  proto_parser_init(&p);
  CHECK_EQ(feed("FF 00 0D 37"), 0);                       /* noise only */
  CHECK_EQ(feed("21 01 00 00 01 01 0D"), 1);              /* still locks on */
  CHECK_EQ(feed("21 01 00 00 01 01 55"), 0);              /* wrong end byte: dropped */
  CHECK_EQ(feed("21 01 1D 00 01 05 0D"), 1); CHECK_EQ(f.cmd, 0x1D);
  CHECK_EQ(feed("21 01 5E 00 09 41 42 43"), 0);           /* length 9 > PROTO_MAX_DATA: dropped */
  CHECK_EQ(feed("21 01 00 00 01 00 0D"), 1); CHECK_EQ(f.data[0], 0x00);
  CHECK_EQ(feed("21 01 00"), 0); CHECK(proto_parser_busy(&p));   /* truncated */
  proto_parser_init(&p);                                         /* what the gap timeout does */
  CHECK_EQ(feed("21 01 00 00 01 01 0D"), 1);
}
int main(void) {
  RUN(test_build_commands); RUN(test_parse_power_reply); RUN(test_parse_error_answer_and_zero_length);
  RUN(test_data_bytes_that_look_like_framing); RUN(test_back_to_back_frames); RUN(test_garbage_and_truncated_frames);
  TEST_MAIN_END();
}
```

- [ ] **Step 3: Write `firmware/Makefile`** with a `test` target. Each `firmware/test/test_X.c` becomes `build/host/test_X`, compiled with host `gcc`, `-Isrc -Itest`, the Global Constraints flags, and linked with the `src/*.c` files it needs (list them per test). `test` runs every binary and stops on the first non-zero exit.
- [ ] **Step 4: Run** `tools/dev make -C firmware test` — expected: compile error (`proto.h` missing).
- [ ] **Step 5: Write `config.h`** (the table above) **and `proto.h` / `proto.c`.**
- [ ] **Step 6: Run** `tools/dev make -C firmware test` — expected: `0 failed`.
- [ ] **Step 7: Commit** — `feat(fw): frame protocol and host test harness`

---

### Task 2: Command table

**Files:**
- Create: `firmware/src/cmds.h`, `firmware/src/cmds.c`, `firmware/test/test_cmds.c`
- Modify: `firmware/Makefile`

**Interfaces:**
- Consumes: `proto_build`, `ctrl_send_t` (declare the enum in `ctrl.h` now; Task 3 fills the rest of that header).
- Produces: `uint8_t cmds_build(ctrl_send_t what, uint8_t *buf);` writes the frame for `what`, returns its length (0 for `SEND_NONE`). Buffer must hold 8 bytes.

Bytes (spec section 3.2):

| Action | Default | With the RC5 option |
|---|---|---|
| `SEND_POWER_QUERY` | `21 01 00 01 F0 0D` | same |
| `SEND_POWER_ON` | `21 01 00 01 01 0D` | `CFG_POWER_RC5`: `21 01 08 02 10 7B 0D` |
| `SEND_INPUT_QUERY` | `21 01 1D 01 F0 0D` | same |
| `SEND_SELECT_STB` | `21 01 1D 01 05 0D` | `CFG_INPUT_RC5`: `21 01 08 02 10 64 0D` |

- [ ] **Step 1: Write the failing test** `firmware/test/test_cmds.c`: one `CHECK_HEX` per row of the table, with `#if CFG_POWER_RC5` and `#if CFG_INPUT_RC5` choosing the expected string, plus `CHECK_EQ(cmds_build(SEND_NONE, b), 0)`.
- [ ] **Step 2: Extend the Makefile** so `test_cmds` is built and run twice: once with defaults, once with `-DCFG_POWER_RC5=1 -DCFG_INPUT_RC5=1`.
- [ ] **Step 3: Run** — expected: fail (missing `cmds.h`).
- [ ] **Step 4: Write `cmds.h` / `cmds.c`.**
- [ ] **Step 5: Run** `tools/dev make -C firmware test` — expected: `0 failed` for both builds.
- [ ] **Step 6: Commit** — `feat(fw): command table with RC5 fallbacks`

---

### Task 3: Controller state machine

**Files:**
- Create: `firmware/src/ctrl.h`, `firmware/src/ctrl.c`, `firmware/test/test_ctrl.c`
- Modify: `firmware/Makefile`

**Interfaces:**
- Consumes: `proto_frame_t`, `config.h`.
- Produces:
  - `typedef struct ctrl ctrl_t;` (complete type in the header).
  - `void ctrl_init(ctrl_t *c, uint16_t now);`
  - `void ctrl_on_frame(ctrl_t *c, const proto_frame_t *f, uint16_t now);`
  - `ctrl_send_t ctrl_step(ctrl_t *c, uint16_t now);` returns at most one command per call; call it every loop pass.
  - `ctrl_led_t ctrl_led(const ctrl_t *c);`

`now` is a free-running 16-bit millisecond counter. Compare times only as `(int16_t)(now - deadline) >= 0`.

Behaviour rules:

1. **Start.** `ctrl_step` returns `SEND_NONE` until `STARTUP_MS` after `ctrl_init`, then `SEND_POWER_QUERY`.
2. **Awaiting.** After a query, `ctrl_step` returns `SEND_NONE` until the matching reply arrives or `REPLY_TIMEOUT_MS` passes. A reply matches when its `cmd` equals the query's command (`00` for power, `1D` for input). A frame with any other `cmd` does not end the wait.
3. **Power result.** Reply with `answer == 00`, `len >= 1`, `data[0] == 01` means on. Anything else (`data[0] == 00`, a non-zero `answer`, or a timeout) means not on: the next `ctrl_step` returns `SEND_POWER_ON`, and the next power query goes out `WAKE_POLL_MS` after that.
4. **Settle.** When the amp reports on and the previous power result was not on (or there was none), wait `SETTLE_MS` before the input query. When it was already on, send the input query on the next `ctrl_step`.
5. **Input result.** Reply with `answer == 00`, `len >= 1`, `(data[0] & 0x0F) == INPUT_STB` means the input is right: the next cycle (a power query) starts `POLL_MS` later. A good reply with another input: the next `ctrl_step` returns `SEND_SELECT_STB`, and the next cycle starts `WAKE_POLL_MS` after that. A non-zero `answer` or a timeout: send nothing, and start the next cycle `WAKE_POLL_MS` later.
6. **Unsolicited frames.** Every good `cmd 00` or `cmd 1D` frame updates the last power or input result (and so the LED), whether or not it was asked for. While not awaiting that command's reply, a `cmd 00` frame with `data[0] == 00`, or a `cmd 1D` frame whose low nibble is not `INPUT_STB`, also makes the next cycle start on the next `ctrl_step`. If it arrives while awaiting a different command's reply, the current wait finishes first and the cycle carries on from there.
7. **`CFG_INPUT_QUERY == 0`.** Never return `SEND_INPUT_QUERY`. Where rule 4 would send it after a settle, return `SEND_SELECT_STB` once instead; where the amp was already on, send nothing. Treat the input as right afterwards. Rule 6 still applies and leads to another `SEND_SELECT_STB` (after the power query confirms on).
8. **LED.** `LED_FAST` when the most recent power query timed out and no valid frame has arrived since. `LED_SOLID` when the last power result was on and the last input result was right. Otherwise `LED_SLOW`. Before the first result, `LED_SLOW`.

- [ ] **Step 1: Write the failing tests** in `firmware/test/test_ctrl.c`. Helpers and the tests' assertions:

```c
#include "test.h"
#include "proto.h"
#include "ctrl.h"
#include "config.h"

static ctrl_t c; static uint16_t t;
static proto_frame_t fr(uint8_t cmd, uint8_t answer, uint8_t d0) {
  proto_frame_t f = { .zone = 1, .cmd = cmd, .answer = answer, .len = 1, .data = { d0 } }; return f; }
static void rx(uint8_t cmd, uint8_t answer, uint8_t d0) { proto_frame_t f = fr(cmd, answer, d0); ctrl_on_frame(&c, &f, t); }
static ctrl_send_t step(void) { return ctrl_step(&c, t); }
/* advance 1 ms at a time until a command comes out or ms have passed; returns it (or SEND_NONE) */
static ctrl_send_t run(uint16_t ms) { for (uint16_t i = 0; i < ms; i++) { ctrl_send_t s = step(); if (s) return s; t++; } return step(); }
static void start(uint16_t t0) { t = t0; ctrl_init(&c, t); }
/* bring the controller to steady state: on, STB, next poll pending */
static void steady(uint16_t t0) { start(t0); CHECK_EQ(run(STARTUP_MS), SEND_POWER_QUERY); rx(0x00, 0, 1);
  CHECK_EQ(run(SETTLE_MS), SEND_INPUT_QUERY); rx(0x1D, 0, 0x15); CHECK_EQ(ctrl_led(&c), LED_SOLID); }

static void test_startup_delay(void) {
  start(0); t = STARTUP_MS - 1; CHECK_EQ(step(), SEND_NONE); t = STARTUP_MS; CHECK_EQ(step(), SEND_POWER_QUERY);
  CHECK_EQ(ctrl_led(&c), LED_SLOW);
}
static void test_standby_then_power_on_then_requery(void) {
  start(0); run(STARTUP_MS); rx(0x00, 0, 0);
  CHECK_EQ(step(), SEND_POWER_ON); CHECK_EQ(step(), SEND_NONE);
  uint16_t t0 = t; CHECK_EQ(run(WAKE_POLL_MS + 5), SEND_POWER_QUERY); CHECK_EQ(t - t0, WAKE_POLL_MS);
  CHECK_EQ(ctrl_led(&c), LED_SLOW);
}
static void test_timeout_sends_power_on_and_blinks_fast(void) {
  start(0); run(STARTUP_MS); uint16_t t0 = t;
  CHECK_EQ(run(REPLY_TIMEOUT_MS + 5), SEND_POWER_ON); CHECK_EQ(t - t0, REPLY_TIMEOUT_MS);
  CHECK_EQ(ctrl_led(&c), LED_FAST);
  rx(0x00, 0, 0); CHECK_EQ(ctrl_led(&c), LED_SLOW);       /* any valid frame clears "not answering" */
}
static void test_power_error_answer_counts_as_not_on(void) {
  start(0); run(STARTUP_MS); rx(0x00, 0x85, 0); CHECK_EQ(step(), SEND_POWER_ON); CHECK_EQ(ctrl_led(&c), LED_SLOW);
}
static void test_settle_only_on_first_on(void) {
  start(0); run(STARTUP_MS); rx(0x00, 0, 1); uint16_t t0 = t;
  CHECK_EQ(run(SETTLE_MS + 5), SEND_INPUT_QUERY); CHECK_EQ(t - t0, SETTLE_MS);
  rx(0x1D, 0, 0x05); t0 = t;
  CHECK_EQ(run(POLL_MS + 5), SEND_POWER_QUERY); CHECK_EQ(t - t0, POLL_MS);
  rx(0x00, 0, 1); CHECK_EQ(step(), SEND_INPUT_QUERY);     /* already on: no settle */
}
static void test_processor_mode_reply_is_stb(void) { steady(0); CHECK_EQ(step(), SEND_NONE); }
static void test_wrong_input_selects_stb(void) {
  start(0); run(STARTUP_MS); rx(0x00, 0, 1); run(SETTLE_MS); rx(0x1D, 0, 0x06);
  CHECK_EQ(step(), SEND_SELECT_STB); CHECK_EQ(ctrl_led(&c), LED_SLOW);
  uint16_t t0 = t; CHECK_EQ(run(WAKE_POLL_MS + 5), SEND_POWER_QUERY); CHECK_EQ(t - t0, WAKE_POLL_MS);
}
static void test_input_error_or_timeout_never_selects_blind(void) {
  start(0); run(STARTUP_MS); rx(0x00, 0, 1); run(SETTLE_MS); rx(0x1D, 0x85, 0);
  uint16_t t0 = t; CHECK_EQ(run(WAKE_POLL_MS + 5), SEND_POWER_QUERY); CHECK_EQ(t - t0, WAKE_POLL_MS);
  rx(0x00, 0, 1); CHECK_EQ(step(), SEND_INPUT_QUERY);
  t0 = t; CHECK_EQ(run(REPLY_TIMEOUT_MS + WAKE_POLL_MS + 5), SEND_POWER_QUERY);   /* timeout path */
  CHECK_EQ(t - t0, REPLY_TIMEOUT_MS + WAKE_POLL_MS);
}
static void test_unsolicited_wrong_input_triggers_recheck(void) {
  steady(0); t += 100; rx(0x1D, 0, 0x06); CHECK_EQ(step(), SEND_POWER_QUERY); CHECK_EQ(ctrl_led(&c), LED_SLOW);
}
static void test_unsolicited_standby_triggers_recheck(void) {
  steady(0); t += 100; rx(0x00, 0, 0); CHECK_EQ(step(), SEND_POWER_QUERY);
}
static void test_unsolicited_good_state_changes_nothing(void) {
  steady(0); t += 100; rx(0x1D, 0, 0x15); rx(0x00, 0, 1); CHECK_EQ(step(), SEND_NONE); CHECK_EQ(ctrl_led(&c), LED_SOLID);
}
static void test_unsolicited_frame_while_awaiting(void) {
  steady(0); CHECK_EQ(run(POLL_MS + 5), SEND_POWER_QUERY);
  rx(0x1D, 0, 0x06);                       /* front panel change lands before the power reply */
  CHECK_EQ(step(), SEND_NONE);             /* still awaiting the power reply */
  rx(0x00, 0, 1); CHECK_EQ(step(), SEND_INPUT_QUERY);
  rx(0x1D, 0, 0x06); CHECK_EQ(step(), SEND_SELECT_STB);
}
static void test_wraparound(void) {
  steady(65000);                           /* startup, settle and first poll all straddle the wrap */
  uint16_t t0 = t; CHECK_EQ(run(POLL_MS + 5), SEND_POWER_QUERY); CHECK_EQ((uint16_t)(t - t0), POLL_MS);
  t0 = t; CHECK_EQ(run(REPLY_TIMEOUT_MS + 5), SEND_POWER_ON); CHECK_EQ((uint16_t)(t - t0), REPLY_TIMEOUT_MS);
}
int main(void) { /* RUN each test above */ TEST_MAIN_END(); }
```

  Add, in a second file `firmware/test/test_ctrl_noquery.c` built with `-DCFG_INPUT_QUERY=0`:

```c
static void test_noquery_selects_once_after_wake(void) {
  start(0); run(STARTUP_MS); rx(0x00, 0, 1);
  CHECK_EQ(run(SETTLE_MS + 5), SEND_SELECT_STB); CHECK_EQ(ctrl_led(&c), LED_SOLID);
  CHECK_EQ(run(POLL_MS + 5), SEND_POWER_QUERY); rx(0x00, 0, 1);
  CHECK_EQ(run(POLL_MS - 5), SEND_NONE);                 /* already on: nothing more */
}
static void test_noquery_reselects_after_unsolicited_wrong_input(void) {
  start(0); run(STARTUP_MS); rx(0x00, 0, 1); run(SETTLE_MS + 5);
  t += 100; rx(0x1D, 0, 0x06); CHECK_EQ(step(), SEND_POWER_QUERY); rx(0x00, 0, 1); CHECK_EQ(step(), SEND_SELECT_STB);
}
```

- [ ] **Step 2: Run** — expected: fail (`ctrl.h` incomplete).
- [ ] **Step 3: Write `ctrl.h` / `ctrl.c`** to the eight rules. Keep the struct small (it must fit comfortably in 128 bytes of RAM alongside everything else).
- [ ] **Step 4: Run** `tools/dev make -C firmware test` — expected: `0 failed`.
- [ ] **Step 5: Commit** — `feat(fw): controller state machine`

---

### Task 4: Simulated amp, app loop and scenario tests

**Files:**
- Create: `firmware/src/hal.h`, `firmware/src/app.h`, `firmware/src/app.c`, `firmware/test/sim_amp.h`, `firmware/test/sim_amp.c`, `firmware/test/hal_host.h`, `firmware/test/hal_host.c`, `firmware/test/test_app.c`
- Modify: `firmware/Makefile`

**Interfaces:**
- Consumes: `proto_*`, `cmds_build`, `ctrl_*`.
- Produces:
  - `hal.h`:
    ```c
    void     hal_init(void);
    uint16_t hal_millis(void);
    bool     hal_uart_getc(uint8_t *b);                 /* false when nothing waiting */
    void     hal_uart_write(const uint8_t *buf, uint8_t n);
    void     hal_led(bool on);
    void     hal_wdt_kick(void);
    void     hal_dbg_putc(uint8_t b);                   /* CFG_DEBUG only */
    uint8_t  hal_ee_read(uint8_t addr);                 /* CFG_DEBUG only */
    void     hal_ee_update(uint8_t addr, uint8_t v);    /* CFG_DEBUG only; writes only if different */
    ```
  - `app.h`: `void app_init(void); void app_step(void);`
  - `sim_amp.h`:
    ```c
    typedef struct {
      /* settings */
      bool rs232_in_standby;      /* false: completely silent while in standby */
      bool announce;              /* true: sends unsolicited frames on front-panel changes */
      bool processor_mode;        /* true: input replies have 0x10 set */
      uint16_t boot_ms;           /* silent for this long after a power-on command */
      uint16_t reply_delay_ms;    /* default 20 */
      uint16_t input_busy_ms;     /* answers input commands with 0x85 for this long after boot */
      bool disconnected;          /* true: receives nothing, sends nothing */
      /* state */
      bool on; uint8_t input;
      /* counters of commands received */
      uint16_t n_power_query, n_power_on, n_input_query, n_select;
    } sim_amp_t;
    void sim_amp_init(sim_amp_t *a);                     /* off, input 0x06, rs232_in_standby, announce, processor_mode, boot 3000 */
    void sim_amp_front_panel_input(sim_amp_t *a, uint8_t input);
    void sim_amp_front_panel_standby(sim_amp_t *a);
    void sim_amp_front_panel_on(sim_amp_t *a);
    void sim_amp_inject(sim_amp_t *a, const uint8_t *bytes, uint8_t n);   /* raw bytes onto the line toward the dongle */
    ```
    The simulated amp understands commands `00` (data `F0`, `01`, `00`), `1D` (data `F0` or an input code) and `08` (RC5 `10 7B` power on, `10 64` STB; it replies with the echo frame and then a status frame of the affected command). The counters count by meaning, so an RC5 power-on adds to `n_power_on` and an RC5 STB to `n_select`. A select takes effect at once. `sim_amp_front_panel_on` switches on at once, without the boot delay. It parses with its own copy of the frame rules, not with `proto.c`'s response parser (commands have no answer byte).
  - `hal_host.h`: `extern sim_amp_t amp; void host_reset(void); void host_run_ms(uint32_t ms); bool host_led_is_on(void); ctrl_led_t host_led_mode(void); uint8_t *host_eeprom(void);` `host_run_ms` advances the virtual clock 1 ms at a time, moves bytes both ways (respecting `reply_delay_ms`), and calls `app_step()` each millisecond. `host_led_mode` classifies the last 1000 ms of `hal_led` calls: always on → `LED_SOLID`; toggling with a period under 300 ms → `LED_FAST`; otherwise `LED_SLOW`.

`app_step` does, in order: kick the watchdog; read `now`; drain `hal_uart_getc` into the parser, passing complete frames to `ctrl_on_frame`; reset the parser if it is busy and `PARSER_GAP_MS` has passed since the last byte; call `ctrl_step` and, if it returns a command, `cmds_build` and `hal_uart_write`; drive the LED (`LED_SOLID` on; `LED_SLOW` 500 ms on, 500 ms off; `LED_FAST` 100 ms on, 100 ms off). With `CFG_DEBUG`: every received byte also goes to `hal_dbg_putc`; every command sent is preceded on the trace by `FE` then the `ctrl_send_t` value; and the `dbglog_*` hooks from Task 5 are called (leave the hook calls out until Task 5).

- [ ] **Step 1: Write the failing scenario tests** in `firmware/test/test_app.c`

```c
#include "test.h"
#include "hal_host.h"
#include "app.h"

static void boot(void) { host_reset(); app_init(); }      /* host_reset also re-inits amp to defaults */

static void scenario_wake_from_standby(void) {
  boot(); host_run_ms(7000);                              /* 3 s boot + 1.5 s settle + margin */
  CHECK(amp.on); CHECK_EQ(amp.input, 0x05); CHECK_EQ(host_led_mode(), LED_SOLID);
  CHECK(amp.n_power_on >= 1); CHECK_EQ(amp.n_select, 1);
}
static void scenario_steady_state_sends_only_queries(void) {
  boot(); amp.on = true; amp.input = 0x05; host_run_ms(60000);
  CHECK_EQ(amp.n_power_on, 0); CHECK_EQ(amp.n_select, 0); CHECK_EQ(host_led_mode(), LED_SOLID);
  CHECK(amp.n_power_query >= 25 && amp.n_power_query <= 35);      /* about one per 2 s */
}
static void scenario_input_changed_at_front_panel(void) {
  boot(); amp.on = true; amp.input = 0x05; host_run_ms(10000);
  sim_amp_front_panel_input(&amp, 0x06); host_run_ms(5000);
  CHECK_EQ(amp.input, 0x05); CHECK_EQ(amp.n_select, 1);
}
static void scenario_input_changed_without_announcement(void) {
  boot(); amp.on = true; amp.input = 0x05; amp.announce = false; host_run_ms(10000);
  sim_amp_front_panel_input(&amp, 0x06); host_run_ms(5000);
  CHECK_EQ(amp.input, 0x05);
}
static void scenario_standby_at_front_panel(void) {
  boot(); amp.on = true; amp.input = 0x05; amp.announce = false; host_run_ms(10000);
  sim_amp_front_panel_standby(&amp); host_run_ms(2500);
  CHECK(amp.n_power_on >= 1);                             /* command sent within one poll */
  host_run_ms(6000); CHECK(amp.on); CHECK_EQ(amp.input, 0x05);
}
static void scenario_amp_disconnected(void) {
  boot(); amp.disconnected = true; host_run_ms(30000);
  CHECK_EQ(host_led_mode(), LED_FAST); CHECK_EQ(amp.n_select, 0);
}
static void scenario_silent_then_switched_on_by_hand(void) {
  boot(); amp.rs232_in_standby = false; host_run_ms(20000);
  CHECK(!amp.on); CHECK_EQ(host_led_mode(), LED_FAST);
  sim_amp_front_panel_on(&amp); host_run_ms(8000);
  CHECK_EQ(amp.input, 0x05); CHECK_EQ(host_led_mode(), LED_SOLID);
}
static void scenario_input_busy_after_boot(void) {
  boot(); amp.input_busy_ms = 4000; host_run_ms(12000);
  CHECK(amp.on); CHECK_EQ(amp.input, 0x05); CHECK_EQ(amp.n_select, 1);
}
static void scenario_noise_on_the_line(void) {
  boot(); const uint8_t junk[] = {0xFF, 0x21, 0x01, 0x00, 0x00, 0x00, 0x21, 0x0D, 0x37};
  for (int i = 0; i < 20; i++) { sim_amp_inject(&amp, junk, sizeof junk); host_run_ms(700); }
  host_run_ms(8000); CHECK(amp.on); CHECK_EQ(amp.input, 0x05); CHECK_EQ(host_led_mode(), LED_SOLID);
}
static void scenario_long_run_crosses_wrap(void) {
  boot(); amp.on = true; amp.input = 0x05;
  for (int i = 0; i < 7; i++) { host_run_ms(30000); sim_amp_front_panel_input(&amp, 0x02); host_run_ms(5000); CHECK_EQ(amp.input, 0x05); }
  CHECK_EQ(amp.n_power_on, 0); CHECK_EQ(amp.n_select, 7);   /* 245 s: the counter wraps three times */
}
int main(void) { /* RUN each scenario above */ TEST_MAIN_END(); }
```

  Also build `test_app.c` a second time with `-DCFG_POWER_RC5=1 -DCFG_INPUT_RC5=1`; every scenario must pass unchanged.

- [ ] **Step 2: Run** — expected: fail (missing headers).
- [ ] **Step 3: Write `hal.h`, `sim_amp.*`, `hal_host.*`.**
- [ ] **Step 4: Write `app.h` / `app.c`.**
- [ ] **Step 5: Run** `tools/dev make -C firmware test` — expected: `0 failed` for every binary.
- [ ] **Step 6: Commit** — `feat(fw): app loop with simulated-amp scenario tests`

---

### Task 5: Debug reply log and decoder

**Files:**
- Create: `firmware/src/dbglog.h`, `firmware/src/dbglog.c`, `firmware/test/test_dbglog.c`, `tools/decode_eeprom.py`, `tools/tests/test_decode_eeprom.py`
- Modify: `firmware/src/app.c` (call the hooks under `CFG_DEBUG`), `firmware/Makefile`

**Interfaces:**
- Consumes: `hal_ee_read`, `hal_ee_update`, `proto_frame_t`, `ctrl_send_t`.
- Produces:
  - `void dbglog_init(void); void dbglog_sent(ctrl_send_t what); void dbglog_frame(const proto_frame_t *f);`
  - `python tools/decode_eeprom.py <file>` prints the log. It accepts a raw binary dump, or an Intel HEX file in which the EEPROM is either at address 0 or at `0x810000` (Microchip's convention). Function `decode(data: bytes) -> dict`.
  - The test binary `build/host/test_dbglog` writes `build/host/dbglog_golden.bin` (the fake EEPROM after a fixed sequence), which the Python test decodes.

EEPROM layout (104 bytes used of 128):

| Offset | Content |
|---|---|
| 0 | magic `D5` |
| 1 | layout version `01` |
| 2 | boot count, stops at 255 |
| 3 | unused |
| 4 + 20·k | bucket k, for k = 0 power query, 1 power on, 2 input query, 3 select STB, 4 unsolicited |

Each 20-byte bucket: byte 0 = timeouts (stops at 255); byte 1 = number of records (0–3); then three 6-byte records `cmd, answer, len, data0, data1, data2`.

Rules:
- `dbglog_init`: if the magic or version is wrong, write the header and zero every bucket's first two bytes; then add one to the boot count.
- `dbglog_sent(what)`: if the previous command sent got no frame at all before this call, add one to that command's timeout count. Remember `what` as the current command.
- `dbglog_frame(f)`: the first frame after a `dbglog_sent` belongs to that command's bucket; later frames before the next send, and frames before any send, belong to the unsolicited bucket. Store the frame only if the bucket has fewer than 3 records and no identical record already.

- [ ] **Step 1: Write the failing C tests** in `firmware/test/test_dbglog.c` (linked with `hal_host.c` for the fake EEPROM):

```c
static uint8_t *ee; 
static void fresh(void) { host_reset(); ee = host_eeprom(); memset(ee, 0xFF, 128); dbglog_init(); }
static proto_frame_t fr(uint8_t cmd, uint8_t ans, uint8_t d0) { proto_frame_t f = { 1, cmd, ans, 1, { d0 } }; return f; }

static void test_init_writes_header_and_counts_boots(void) {
  fresh(); CHECK_EQ(ee[0], 0xD5); CHECK_EQ(ee[1], 0x01); CHECK_EQ(ee[2], 1);
  for (int k = 0; k < 5; k++) { CHECK_EQ(ee[4 + 20 * k], 0); CHECK_EQ(ee[5 + 20 * k], 0); }
  dbglog_init(); CHECK_EQ(ee[2], 2);
}
static void test_first_frame_goes_to_the_sent_bucket(void) {
  fresh(); dbglog_sent(SEND_POWER_QUERY); proto_frame_t f = fr(0x00, 0, 1); dbglog_frame(&f);
  CHECK_EQ(ee[4 + 1], 1); CHECK_HEX(&ee[4 + 2], 6, "00 00 01 01 00 00");
}
static void test_second_frame_is_unsolicited(void) {
  fresh(); dbglog_sent(SEND_POWER_QUERY); proto_frame_t a = fr(0x00, 0, 1), b = fr(0x1D, 0, 0x15);
  dbglog_frame(&a); dbglog_frame(&b);
  CHECK_EQ(ee[4 + 80 + 1], 1); CHECK_HEX(&ee[4 + 80 + 2], 6, "1D 00 01 15 00 00");
}
static void test_duplicates_not_stored_and_three_record_limit(void) {
  fresh(); for (int i = 0; i < 6; i++) { dbglog_sent(SEND_INPUT_QUERY); proto_frame_t f = fr(0x1D, 0, (uint8_t)(i / 2)); dbglog_frame(&f); }
  CHECK_EQ(ee[4 + 40 + 1], 3);                              /* 0,0,1,1,2,2 -> three distinct */
  dbglog_sent(SEND_INPUT_QUERY); proto_frame_t g = fr(0x1D, 0, 9); dbglog_frame(&g); CHECK_EQ(ee[4 + 40 + 1], 3);
}
static void test_timeouts_counted_per_command(void) {
  fresh(); dbglog_sent(SEND_POWER_QUERY); dbglog_sent(SEND_POWER_ON); dbglog_sent(SEND_POWER_QUERY);
  CHECK_EQ(ee[4 + 0], 1); CHECK_EQ(ee[4 + 20], 1);
}
static void test_error_answer_is_recorded(void) {
  fresh(); dbglog_sent(SEND_SELECT_STB); proto_frame_t f = { 1, 0x1D, 0x85, 0, { 0 } }; dbglog_frame(&f);
  CHECK_HEX(&ee[4 + 60 + 2], 6, "1D 85 00 00 00 00");
}
/* main: RUN the tests, then replay a fixed sequence on a fresh EEPROM and fwrite(ee, 1, 128, "build/host/dbglog_golden.bin"):
   sent POWER_QUERY; sent POWER_ON (so one power-query timeout); frame 00/00/01;
   sent INPUT_QUERY; frame 1D/00/15; frame 1D/00/06 (unsolicited); sent SELECT_STB; frame 1D/85 len 0. */
```

- [ ] **Step 2: Write the failing Python test** `tools/tests/test_decode_eeprom.py`

```python
import pathlib, subprocess
from tools import decode_eeprom as d

GOLD = pathlib.Path("firmware/build/host/dbglog_golden.bin")

def setup_module():
    subprocess.run(["make", "-C", "firmware", "test"], check=True, capture_output=True)

def test_decodes_golden_log():
    log = d.decode(GOLD.read_bytes())
    assert log["boots"] == 1
    assert log["power_query"] == {"timeouts": 1, "records": []}
    assert log["power_on"]["records"] == [{"cmd": 0x00, "answer": 0x00, "data": [0x01]}]
    assert log["input_query"]["records"] == [{"cmd": 0x1D, "answer": 0x00, "data": [0x15]}]
    assert log["unsolicited"]["records"] == [{"cmd": 0x1D, "answer": 0x00, "data": [0x06]}]
    assert log["select_stb"]["records"] == [{"cmd": 0x1D, "answer": 0x85, "data": []}]

def test_blank_eeprom_is_reported_not_decoded():
    assert d.decode(bytes([0xFF]) * 128) == {"error": "no log found (EEPROM blank or not a debug build)"}

def test_intel_hex_at_microchip_offset(tmp_path):
    raw = GOLD.read_bytes()
    assert d.load(d.to_ihex(raw, base=0x810000, path=tmp_path / "e.hex")) == raw

def test_text_names_error_answers():
    assert "0x85 (command invalid at this time)" in d.render(d.decode(GOLD.read_bytes()))
```

- [ ] **Step 3: Run both** — expected: fail.
- [ ] **Step 4: Write `dbglog.*`, add the hooks to `app.c` under `#if CFG_DEBUG`, write `tools/decode_eeprom.py`** (standard library only; `load(path) -> bytes`, `decode`, `render(log) -> str`, `to_ihex` for the test). `render` names the answer codes from spec section 3.2.
- [ ] **Step 5: Add a debug build of the scenario tests** to the Makefile (`test_app` with `-DCFG_DEBUG=1`), so the debug hooks are exercised by every scenario.
- [ ] **Step 6: Run** `tools/dev make -C firmware test` and `tools/dev pytest tools/tests -q` — expected: all pass.
- [ ] **Step 7: Commit** — `feat(fw): debug reply log and decoder`

---

### Task 6: AVR hardware layer, fuses and release builds

**Files:**
- Create: `firmware/src/hal_avr.c`, `firmware/src/main.c`, `firmware/FUSES.md`, `tools/check_fuses.py`, `tools/tests/test_check_fuses.py`
- Modify: `firmware/Makefile`
- Generated: `firmware/release/*.hex`, `firmware/release/SIZES.md`

**Interfaces:**
- Consumes: `hal.h`, `app.h`.
- Produces:
  - `make -C firmware avr` builds all 16 variants to `firmware/release/dongle-p{d|r}-i{d|r}-q{1|0}[-dbg].hex` (`p` power command direct or RC5, `i` input command direct or RC5, `q` input query on or off, `-dbg` for `CFG_DEBUG=1`), runs the size gate and the fuse gate on each, and writes `SIZES.md`.
  - `python tools/check_fuses.py <hex>` exits 0 when the fuse bytes are exactly the expected set, 1 otherwise (including when the hex has no fuse records).

Hardware layer:
- **Clock:** leave the reset default (20 MHz oscillator, divide by 6).
- **USART0:** PA6 output driven high before enabling; PA7 input. `BAUD = 4 × F_CPU / 38400` (347), corrected with the factory value: `baud += (int32_t)baud × (int8_t)SIGROW.OSC20ERR3V / 1024`. 8N1. Receive by interrupt into a 16-byte ring buffer; transmit by polling `DREIF`.
- **Tick:** TCB0 periodic interrupt every 1 ms (`CCMP = F_CPU / 1000 − 1`), incrementing a 16-bit counter; `hal_millis` reads it with interrupts briefly off.
- **LED:** PA3.
- **Watchdog:** enabled by fuse; `hal_wdt_kick` is `wdt_reset()`.
- **Debug trace (`CFG_DEBUG`):** PA1 idles high; `hal_dbg_putc` bit-bangs one 38,400 baud 8N1 byte with interrupts off for that byte (260 µs; the USART's two-byte receive buffer covers it).
- **EEPROM (`CFG_DEBUG`):** `eeprom_read_byte` / `eeprom_update_byte`.
- `main` calls `hal_init()`, enables interrupts, calls `app_init()`, then loops on `app_step()`.

Fuses, declared in `main.c` with avr-libc's `FUSES` so they are in the hex at `0x820000`:

| Index | Fuse | Value | Why |
|---|---|---|---|
| 0 | WDTCFG | `0x0A` | watchdog always on, 4 s |
| 1 | BODCFG | `0x44` | brown-out detector on while running, 2.6 V |
| 2 | OSCCFG | `0x02` | 20 MHz oscillator (default) |
| 4 | TCD0CFG | `0x00` | default |
| 5 | SYSCFG0 | `0xF6` | default: PA0 stays UPDI, EEPROM erased with chip erase |
| 6 | SYSCFG1 | `0x07` | default start-up time 64 ms |
| 7 | APPEND | `0x00` | default |
| 8 | BOOTEND | `0x00` | default |

- [ ] **Step 1: Write the failing test** `tools/tests/test_check_fuses.py`

```python
from tools import check_fuses as cf

GOOD = bytes([0x0A, 0x44, 0x02, 0xFF, 0x00, 0xF6, 0x07, 0x00, 0x00])

def hexfile(tmp_path, fuses, base=0x820000):
    p = tmp_path / "f.hex"; cf.write_test_hex(p, {0x0000: bytes(16), base: fuses}); return p

def test_good_fuses_pass(tmp_path):
    assert cf.check(hexfile(tmp_path, GOOD)) == []

def test_updi_disabled_is_rejected(tmp_path):
    bad = bytearray(GOOD); bad[5] = 0xF2            # RSTPINCFG = GPIO
    assert any("UPDI" in e for e in cf.check(hexfile(tmp_path, bytes(bad))))

def test_wrong_watchdog_or_brownout_rejected(tmp_path):
    bad = bytearray(GOOD); bad[0] = 0x00; bad[1] = 0x00
    errs = cf.check(hexfile(tmp_path, bytes(bad)))
    assert any("WDTCFG" in e for e in errs) and any("BODCFG" in e for e in errs)

def test_missing_fuse_records_rejected(tmp_path):
    p = tmp_path / "n.hex"; cf.write_test_hex(p, {0x0000: bytes(16)})
    assert cf.check(p) == ["no fuse records at 0x820000"]
```

  Index 3 is a reserved byte; `check` ignores it.

- [ ] **Step 2: Run** `tools/dev pytest tools/tests/test_check_fuses.py -q` — expected: fail.
- [ ] **Step 3: Write `tools/check_fuses.py`** (standard library; handles Intel HEX extended linear address records).
- [ ] **Step 4: Write `hal_avr.c`, `main.c` and `FUSES.md`** (the table above, plus one warning line: never change SYSCFG0 bits 3:2).
- [ ] **Step 5: Extend the Makefile.** AVR flags: `-mmcu=attiny412 -Os -flto -ffunction-sections -fdata-sections -Wl,--gc-sections -DF_CPU=3333333UL` plus the Global Constraints flags. Hex: `avr-objcopy -O ihex -R .eeprom -R .lock -R .signature -R .user_signatures` (keep `.fuse`). Size gate per variant: from `avr-size -A`, `.text + .data` ≤ 4096 and `.data + .bss` ≤ 200 (leaving at least 56 bytes of stack); fail the build otherwise. `SIZES.md` lists flash and RAM for each variant and states whether `dongle-pd-id-q1.hex` is within 2048 bytes.
- [ ] **Step 6: Build.**

Run: `tools/dev make -C firmware avr`
Expected: 16 hex files, every size gate and fuse gate passing. If avr-libc's `iotn412.h` names the fuse struct members differently from the table, follow the header and keep the byte values. If the header's default for a row marked "default" differs from the table, use the header's default and update the table, `FUSES.md` and the test together; SYSCFG0 bits 3:2 must still be `01`.

- [ ] **Step 7: Inspect the output.** Run `tools/dev avr-objdump -d firmware/build/avr/dongle-pd-id-q1.elf | head -60` and `tools/dev avr-nm --size-sort firmware/build/avr/dongle-pd-id-q1.elf | tail -15`. Confirm the two interrupt vectors used (USART0 receive, TCB0) point at handlers, and nothing unexpectedly large is linked in.
- [ ] **Step 8: Commit** — `feat(fw): AVR hardware layer, fuses and release hex files`

---

### Task 7: Documentation and the written bring-up procedure

**Files:**
- Create: `docs/research.md`, `docs/flashing.md`, `docs/bring-up.md`
- Modify: `README.md` (link the three documents)

**Interfaces:**
- Consumes: `firmware/release/`, `tools/decode_eeprom.py`, spec sections 3, 7.3 and 11.

Anything in these documents that has not been tried on real hardware must say so in the sentence that states it.

- [ ] **Step 1: Write `docs/research.md`.** The protocol facts from spec section 3.2 (serial settings, pins, frame format, answer codes, command and fallback tables, the "RS232 Stdby" setting, processor-mode nibble), the WiiM trigger facts from 3.1, and the source URLs from spec section 12. State for each fact whether it is from a document for the SA550 itself or inferred from the SA750 and SA10/SA20 documents.
- [ ] **Step 2: Write `docs/flashing.md`.**
  - Cable: TC2030-MCP-NL from the ICD 5's jack to the board's footprint; board powered from the trigger or a 12 V supply.
  - MPLAB IPE on a desktop: device ATtiny412, tool ICD 5, interface UPDI, load the hex, program; how to read the device and export the EEPROM to a hex file.
  - Command line on the headless box (untested until the ICD 5 is connected, and the install needs the owner's sudo password): MPLAB X v6.35's unattended installer (`./MPLABX-v6.35-linux-installer.sh --nox11 -- --unattendedmodeui none --mode unattended --ipe 1 --collectInfo 0`), the known checksum failure of that installer on recent Ubuntu and its workaround, then `ipecmd.sh -TPICD5 -PATtiny412 -ORIUPDI -M -F<hex> -OL`, located with `find /opt/microchip -name ipecmd.sh`; reading back with `-GF<file>`.
  - Whether the fuse records in the hex are applied automatically is unverified; give the manual values from `firmware/FUSES.md` and how to set them in MPLAB IPE.
  - Decoding a dump: `tools/dev python tools/decode_eeprom.py <file>`.
- [ ] **Step 3: Write `docs/bring-up.md`**, a procedure the owner can follow alone, as numbered steps each with "do", "expect" and "if not":
  1. Checks needing no board: trigger polarity and voltage; with "RS232 Stdby" switched on in the amp's menu, which of DB9 pins 2 and 3 idles negative against pin 5.
  2. Bare board on the trigger: 3.3 V at the test pad; LED off (blank chip).
  3. Flash `dongle-pd-id-q1-dbg.hex`. Expect a fast blink (no amp).
  4. Scope the `TX` wire pad: about ±5.5 V, frames `21 01 00 01 F0 0D` and `21 01 00 01 01 0D` alternating about every half second... the exact cadence follows the constants in `config.h`.
  5. Solder the serial cable (`TX` to DB9 pin 2, `RX` to pin 3, `GND` to pin 5), amp in standby, WiiM output turned down. Apply the trigger.
  6. Read the LED: solid = working; slow = amp answers but is not yet on STB; fast = amp not answering.
  7. A decision table from LED pattern and decoded EEPROM log to the next file to flash:
     - fast blink, no records → swap the `TX` and `RX` wires; check "RS232 Stdby";
     - power-on answered with an error or never takes effect → `dongle-pr-id-q1-dbg.hex`;
     - select answered with an error → `...-ir-...`;
     - input query answered with an error or never answered → `...-q0-...`;
     - all good → flash the same variant without `-dbg`.
  8. Processor-mode check: the input-query record should show data `15`; confirm the volume is still fixed before turning the WiiM back up.
  9. Acceptance checks from spec section 11, as a tick list.
  10. What to send back if stuck: the decoded log text, the LED pattern, and a scope capture of `TX` and `RX`.
- [ ] **Step 4: Check every command in the three documents** that can run without hardware by running it (`decode_eeprom.py` on the golden file, the `make` targets). Fix any that fail.
- [ ] **Step 5: Commit** — `docs: protocol research, flashing guide and bring-up procedure`
