FyrBridd/ext_trigger_jbl_sa550/enclosure/out/enclosure.pdf

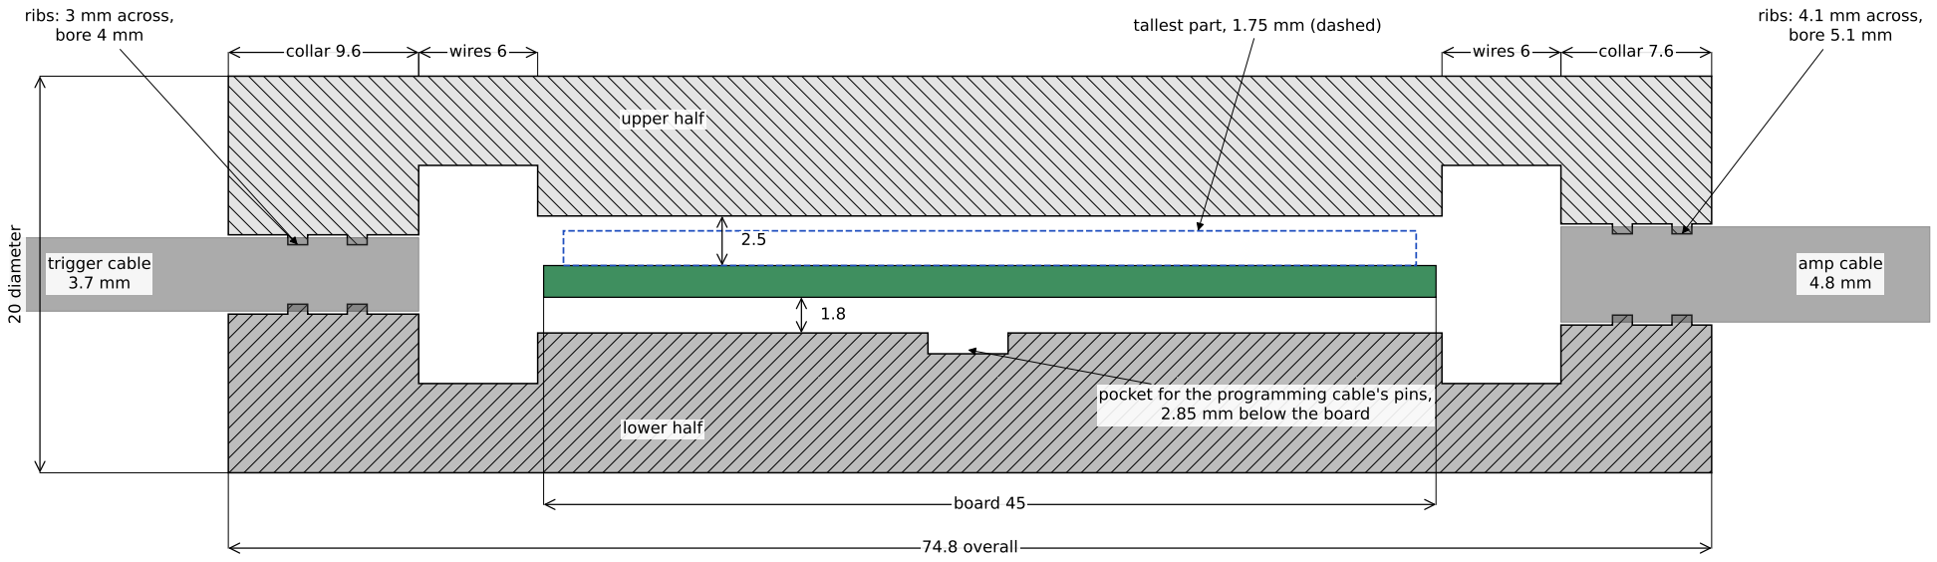
[picture p6: figure]
trigger cable 3.7 mm; ribs: 3 mm across, bore 4 mm; amp cable 4.8 mm; ribs: 4.1 mm across, bore 5.1 mm; 74.8 overall; board 45; collar 9.6; wires 6; collar 7.6; 20 diameter; tallest part, 1.75 mm (dashed); 2.85 mm below the board; upper half; lower half

pocket for the programming cable's pins,

## Section along the centreline (y = 0), trigger end on the left

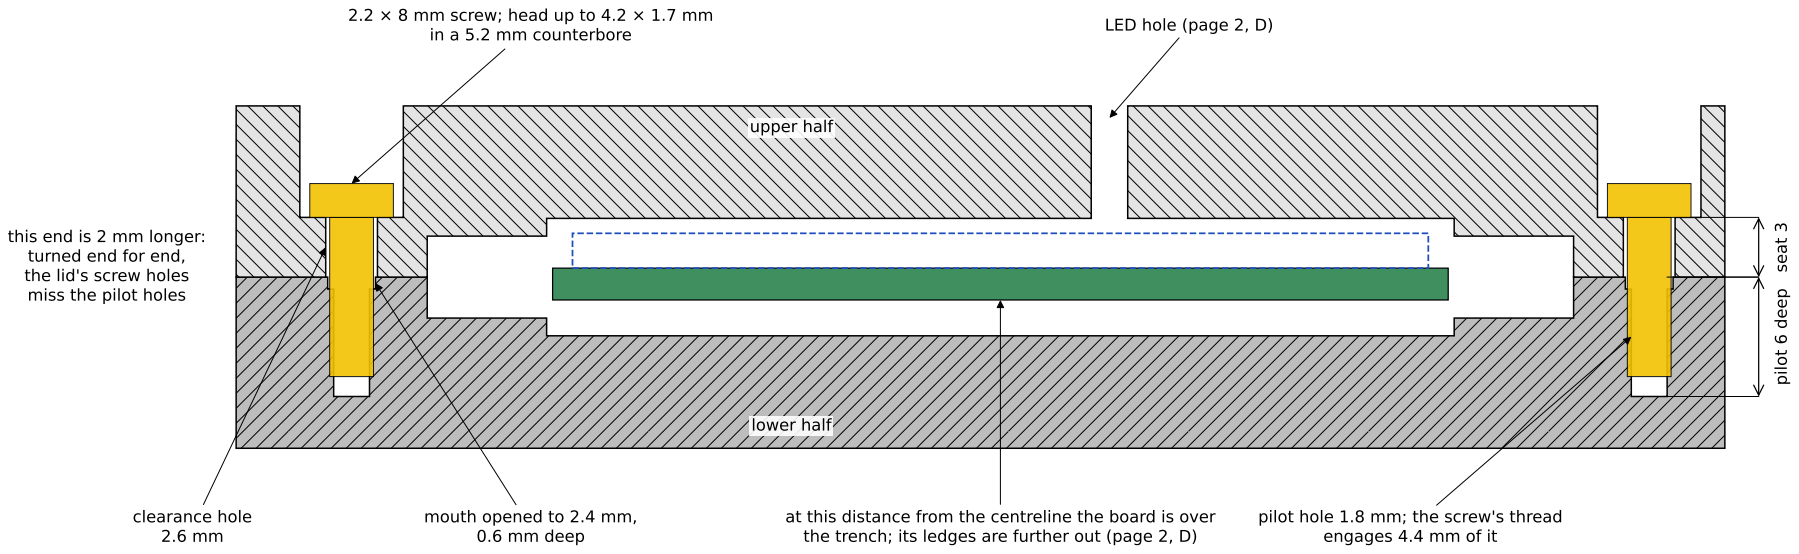
[picture p7: figure]
in a 5.2 mm counterbore; seat 3 pilot 6 deep; pilot hole 1.8 mm; the screw's thread engages 4.4 mm of it; mouth opened to 2.4 mm, 0.6 mm deep; clearance hole 2.6 mm; LED hole (page 2, D); upper half; lower half; this end is 2 mm longer: turned end for end, the lid's screw holes miss the pilot holes

2.2 × 8 mm screw; head up to 4.2 × 1.7 mm

at this distance from the centreline the board is over the trench; its ledges are further out (page 2, D)

## Section through one pair of screws (y = +5.1)

# Dongle enclosure — 1 of 3: sections along the shell

Millimetres. Hatched = printed nylon (darker: lower half). Green = the board. Outlines are cut from the STEP solids by enclosure/export.py.

## A. Trigger-end screws (x = -10.1)

## B. Trigger-end wire chamber (x = −3)

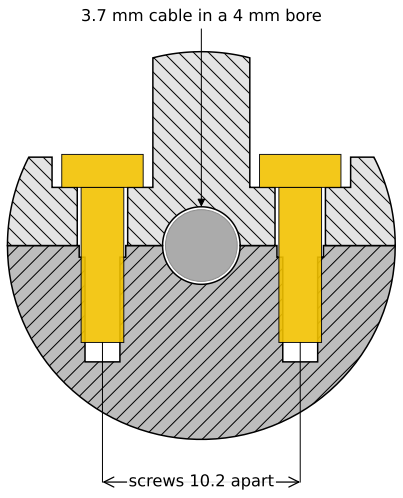
[picture p8: figure]
3.7 mm cable in a 4 mm bore; screws 10.2 apart
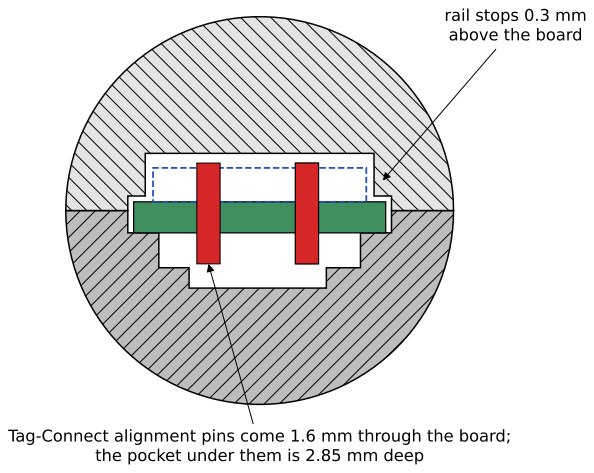
[picture p9: figure]
the pocket under them is 2.85 mm deep; rail stops 0.3 mm above the board

Tag-Connect alignment pins come 1.6 mm through the board;

## C. Programming footprint (x = 21.4)

## D. LED hole (x = 27.98)

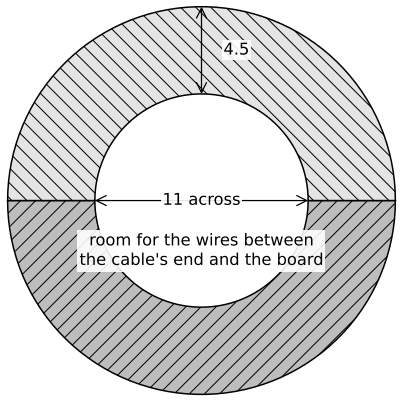
[picture p10: figure]
11 across; room for the wires between the cable's end and the board
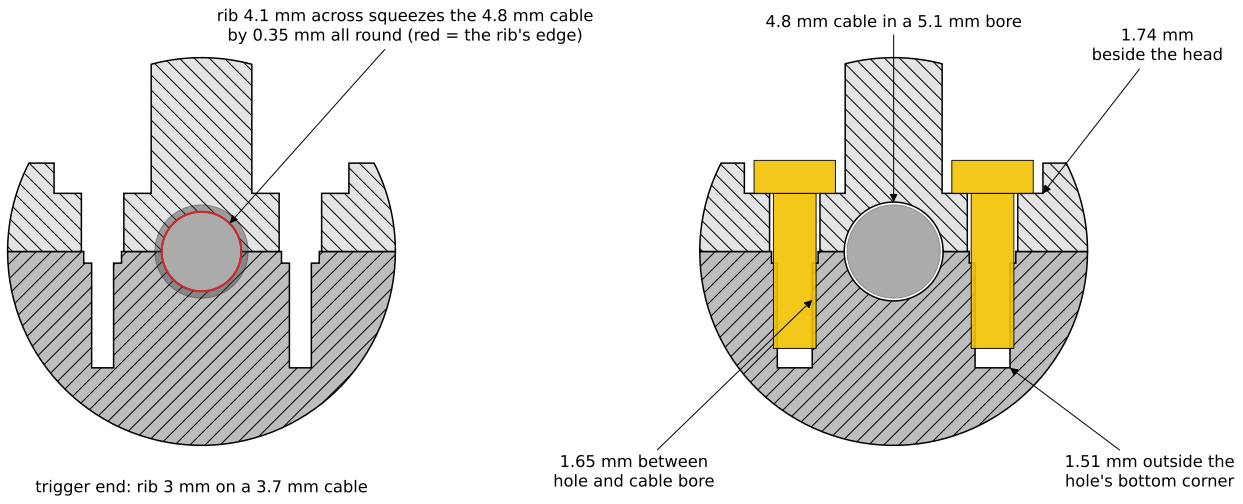
[picture p11: figure]
trigger end: rib 3 mm on a 3.7 mm cable; 1.51 mm outside the hole's bottom corner; 1.74 mm beside the head; 1.65 mm between hole and cable bore; 4.8 mm cable in a 5.1 mm bore
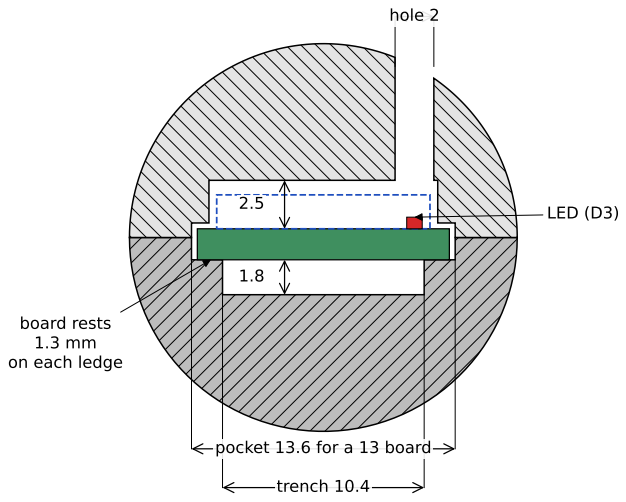
[picture p12: figure]
LED (D3); hole 2; pocket 13.6 for a 13 board; trench 10.4; board rests 1.3 mm on each ledge

rib 4.1 mm across squeezes the 4.8 mm cable by 0.35 mm all round (red = the rib's edge)

## E. Amp-end collar at a rib (x = 54.4)

## F. Amp-end screws (x = 55.1)

# Dongle enclosure — 2 of 3: sections across the shell

Millimetres. Each is seen from the amp end, so +y (the board's upper edge in board.pdf, where the LED is) is on the right. Hatched = printed nylon. Yellow = screws. Blue dashes = tallest part.

Lower half from above (the side the board drops into). Darker = deeper.

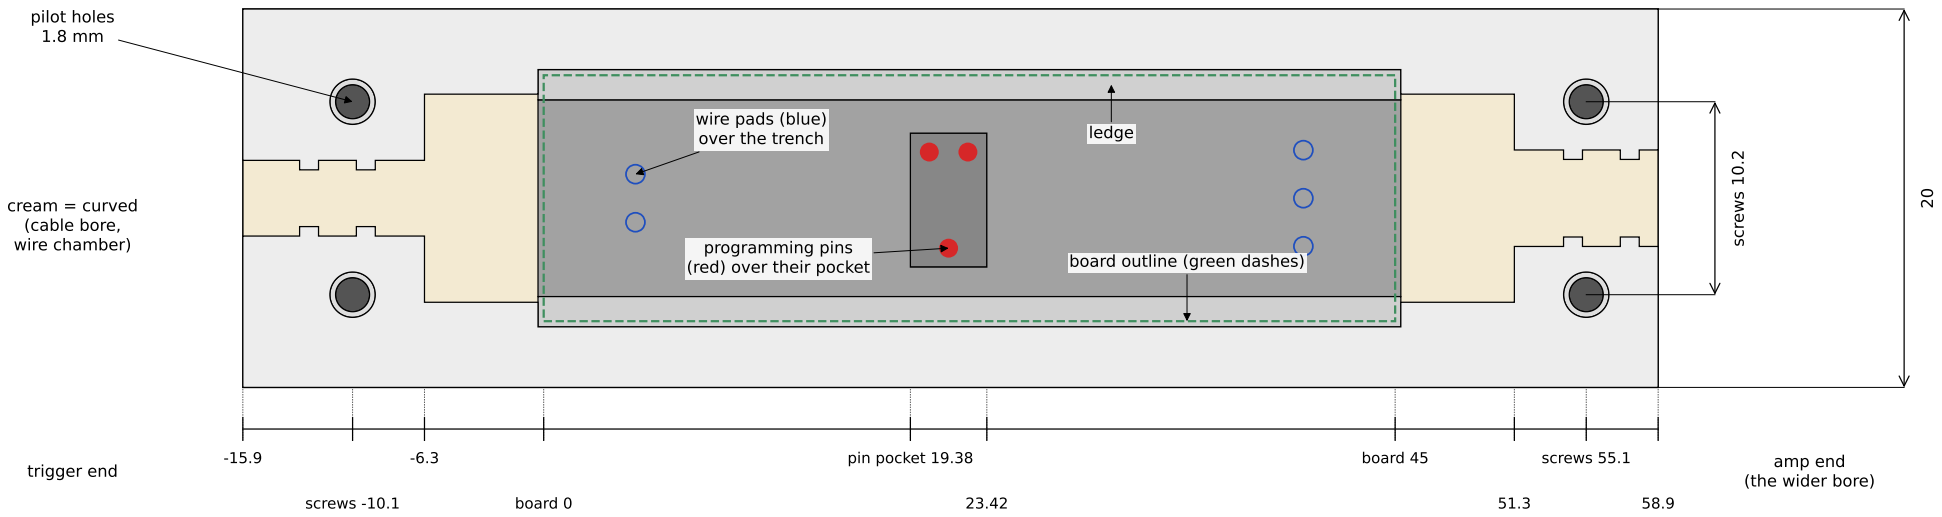
[picture p13: figure]
programming pins (red) over their pocket; wire pads (blue) over the trench; board outline (green dashes); ledge; pilot holes 1.8 mm; cream = curved (cable bore, wire chamber); amp end (the wider bore) trigger end; screws -10.1; board 0; pin pocket 19.38; board 45; screws 55.1; screws 10.2

centreline

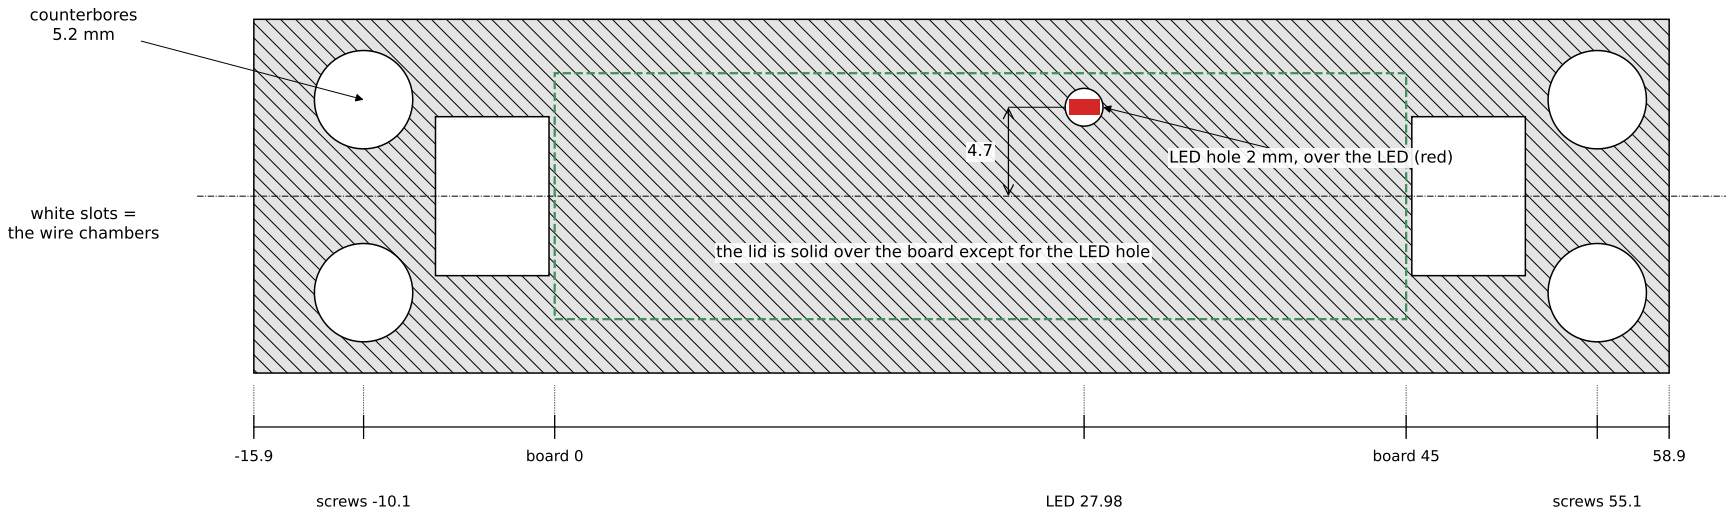
[picture p14: figure]
LED hole 2 mm, over the LED (red); counterbores 5.2 mm; white slots = the wire chambers; screws -10.1; board 0; LED 27.98; board 45; screws 55.1

the lid is solid over the board except for the LED hole

Upper half from above, sliced 3.55 mm above the split: every opening through the lid.

# Dongle enclosure — 3 of 3: views from above

Millimetres. Trigger end on the left; +y (the board's upper edge in board.pdf) at the top, as in board.pdf page 1. Positions along the shell are measured from the board's trigger-end edge.
