FyrBridd/ext_trigger_jbl_sa550/hardware/fab/stock-report.md

# JLCPCB stock check, 2026-11-11

Result: **all parts in stock** (minimum 200 of each).

| LCSC | Part | Fitted as | Kind | In stock | Enough |
|---|---|---|---|---|---|
| C14289 | HT7533-1 (SOT-89-3) | U1 | Basic | 226,665 | yes |
| C1337190 | ATTINY412-SSNR (SOIC-8) | U2 | Extended | 1,811 | yes |
| C13482 | SP3232EEY-L/TR (TSSOP-16) | U3 | Basic | 250,126 | yes |
| C8598 | B5819W SL (SOD-123) | D1,D4 | Basic | 382,201 | yes |
| C19077510 | SMF15CA (SOD-123FL) | D2 | Preferred extended | 8,221,851 | yes |
| C2286 | KT-0603R (0603) | D3 | Basic | 6,117,418 | yes |
| C15850 | CL21A106KAYNNNE (0805) | C1,C2 | Basic | 8,250,058 | yes |
| C14663 | CC0603KRX7R9BB104 (0603) | C3,C4,C5,C6,C7,C8 | Basic | 34,676,745 | yes |
| C22775 | 0603WAF1000T5E (0603) | R1 | Basic | 8,632,827 | yes |
| C21190 | 0603WAF1001T5E (0603) | R2 | Basic | 26,051,724 | yes |
| C25804 | 0603WAF1002T5E (0603) | R3 | Basic | 43,667,996 | yes |

Alternate controllers for the same footprint (not on the bill of materials):

| LCSC | Part | In stock |
|---|---|---|
| C616056 | ATtiny402-SSNR, same 4 KB flash | 1,866 |
| C2052951 | ATtiny202-SSNR, only 2 KB flash | 3,711 |
