FyrBridd/ext_trigger_jbl_sa550/hardware/fab/bom.csv

Comment | Designator | Footprint | LCSC Part #
HT7533-1 | U1 | SOT-89-3 | C14289
ATtiny412-SSNR | U2 | SOIC-8_3.9x4.9mm_P1.27mm | C1337190
SP3232EEY | U3 | TSSOP-16_4.4x5mm_P0.65mm | C13482
B5819W | D1,D4 | D_SOD-123 | C8598
SMF15CA | D2 | D_SOD-123F | C19077510
RED | D3 | LED_0603_1608Metric | C2286
10u 25V | C1,C2 | C_0805_2012Metric | C15850
100n 50V | C3,C4,C5,C6,C7,C8 | C_0603_1608Metric | C14663
100R | R1 | R_0603_1608Metric | C22775
1k | R2 | R_0603_1608Metric | C21190
10k | R3 | R_0603_1608Metric | C25804
