FyrBridd/ext_trigger_jbl_sa550/enclosure/out/upper.step

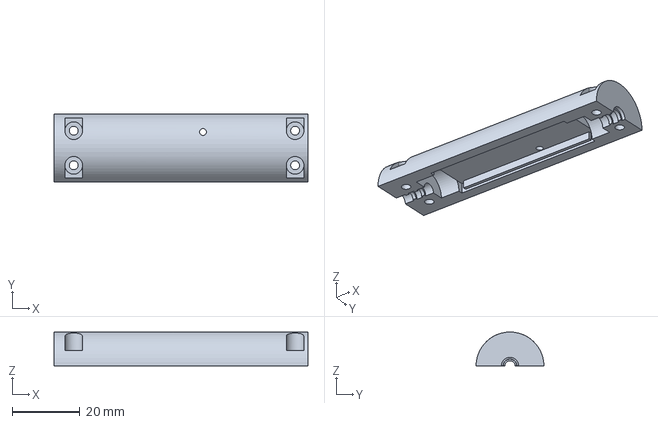
[picture p15: CAD file, 2026-11-11]
enclosure/out/upper.step
74.8 x 20.0 x 10.0 mm
