FyrBridd/ext_trigger_jbl_sa550/hardware/fab/dongle.step

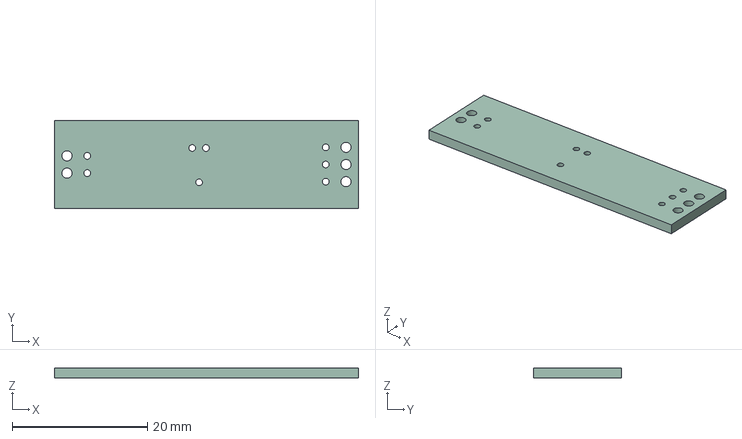
[picture p16: CAD file, 2026-11-11]
hardware/fab/dongle.step
45.0 x 13.0 x 1.51 mm
