FyrBridd/ext_trigger_jbl_sa550/enclosure/out/lower.step

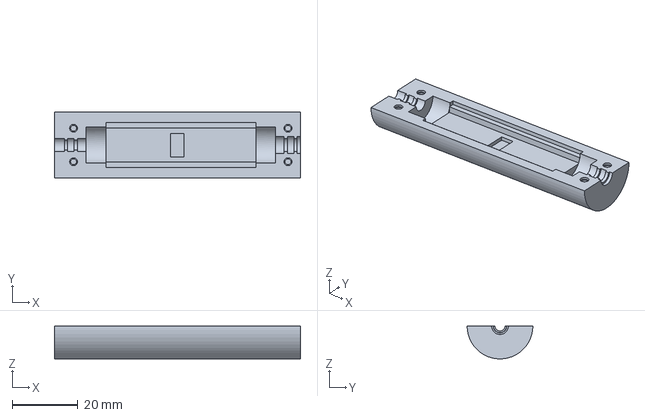
[picture p17: CAD file, 2026-11-11]
enclosure/out/lower.step
74.8 x 20.0 x 10.0 mm
