FyrBridd/ext_trigger_jbl_sa550/(list of files, cad)

Other CAD files:
enclosure/out/lower.stl
enclosure/out/upper.stl
