FyrBridd/ext_trigger_jbl_sa550/hardware/fab/board.pdf

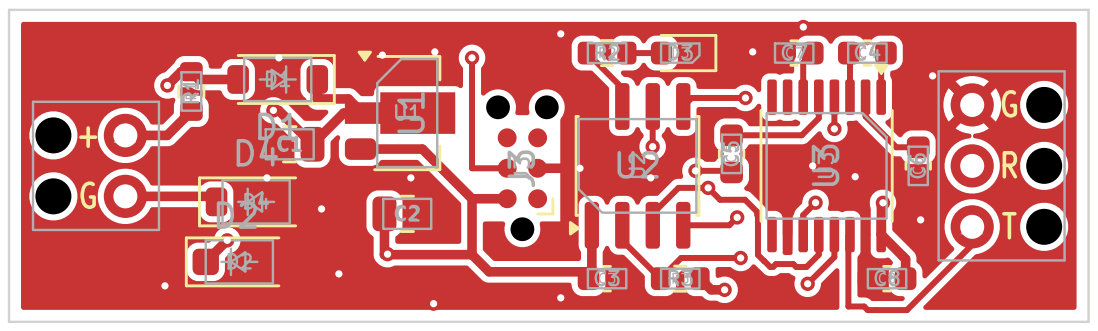
[picture p18: page 1]

Generated from hardware/design - do not edit by hand
Top: copper, silkscreen and part outlines

Sheet:
File: dongle.kicad_pcb
Title: WiiM trigger to JBL SA550 RS232 dongle - board
KiCad E.D.A. 10.0.8

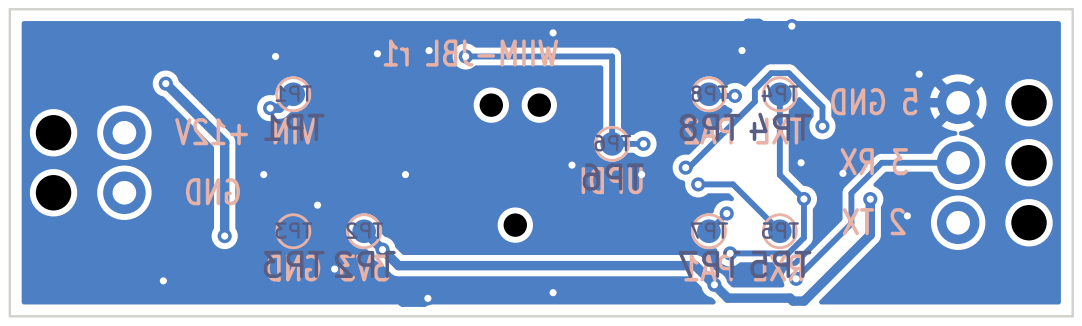
[picture p19: page 2]
D Date:

Generated from hardware/design - do not edit by hand
Bottom: copper and silkscreen (seen through the board from the top)

Sheet:
File: dongle.kicad_pcb
Title: WiiM trigger to JBL SA550 RS232 dongle - board

45.00 mm

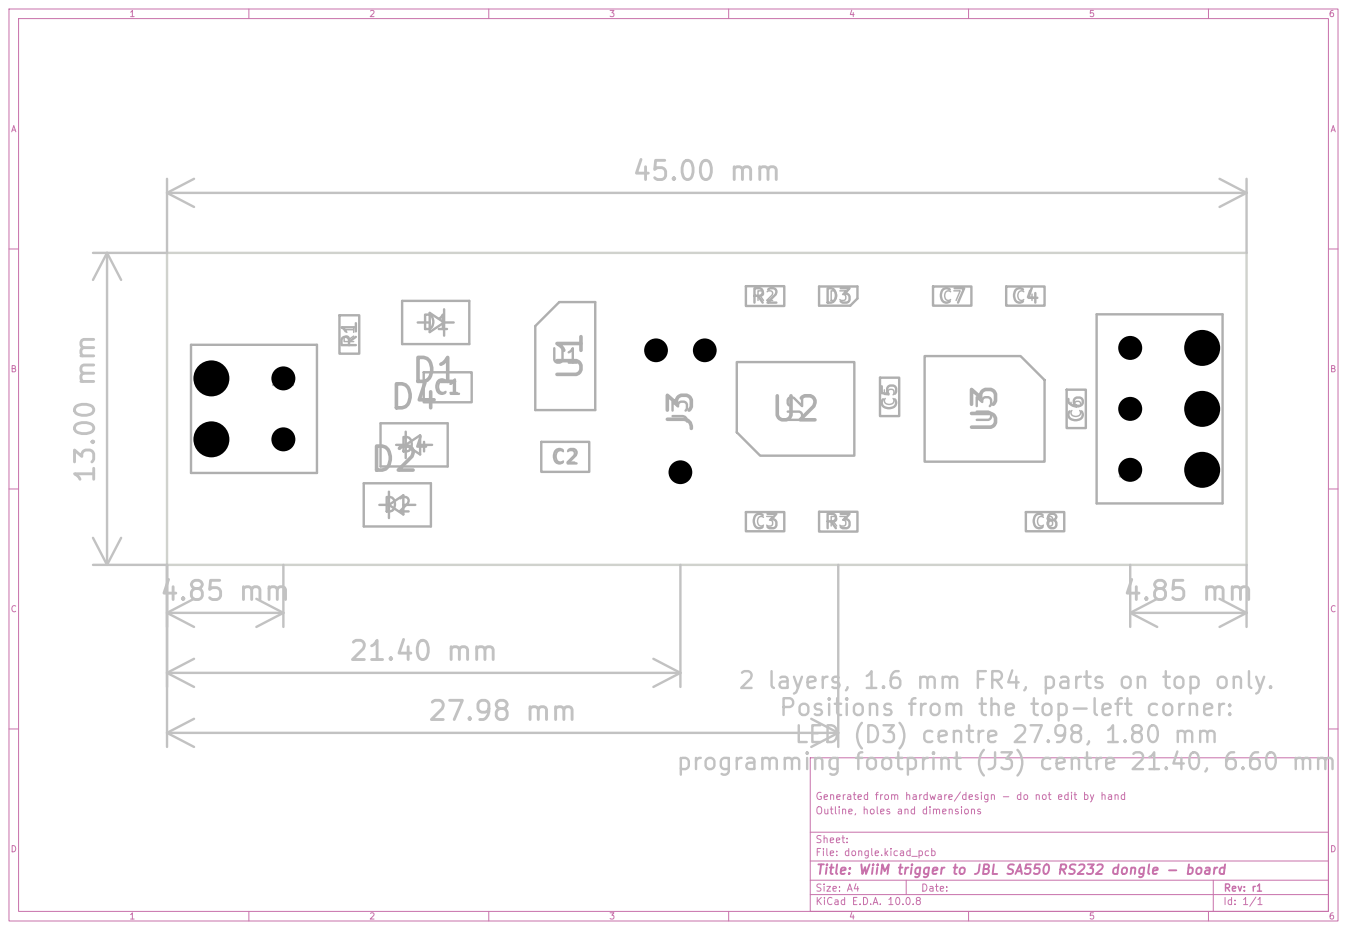
[picture p20: page 3]

2 layers, 1.6 mm FR4, parts on top only.
Positions from the top-left corner:
LED (D3) centre 27.98, 1.80 mm

programming footprint (J3) centre 21.40, 6.60 mm

Generated from hardware/design - do not edit by hand
Outline, holes and dimensions

Sheet:
File: dongle.kicad_pcb
Title: WiiM trigger to JBL SA550 RS232 dongle - board
