FyrBridd/ext_trigger_jbl_sa550/hardware/fab/schematic.pdf

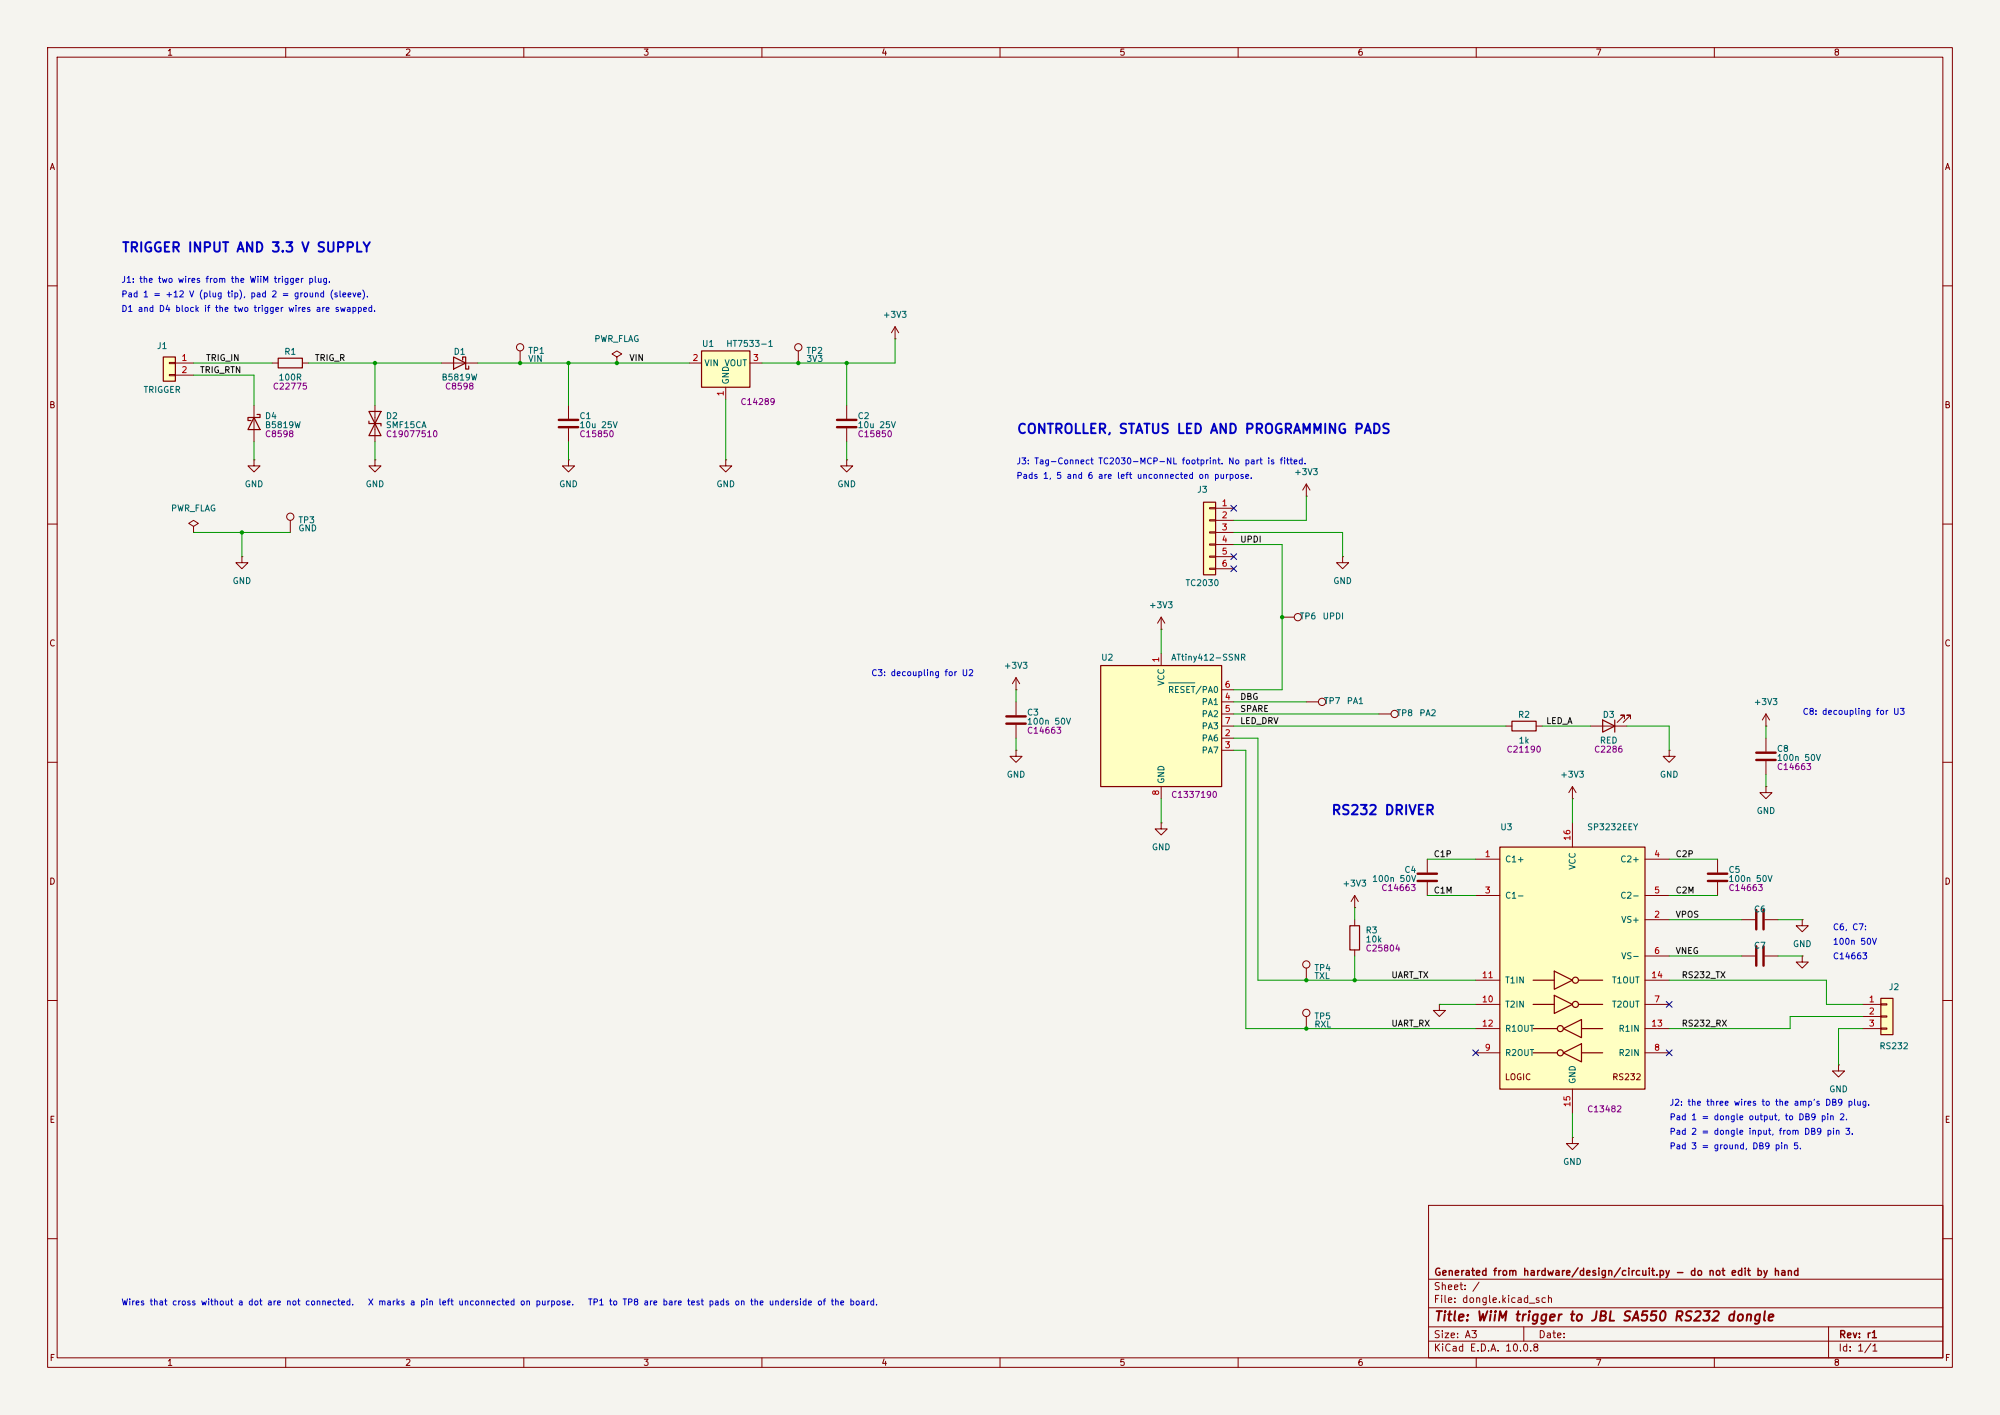
[picture p21: page 1]

TRIGGER INPUT AND 3.3 V SUPPLY

D1 and D4 block if the two trigger wires are swapped. J1: the two wires from the WiiM trigger plug.

C3: decoupling for U2 Pad 1 = +12 V (plug tip), pad 2 = ground (sleeve).

CONTROLLER, STATUS LED AND PROGRAMMING PADS

Pads 1, 5 and 6 are left unconnected on purpose.

Pad 2 = dongle input, from DB9 pin 3. Pad 1 = dongle output, to DB9 pin 2. J2: the three wires to the amp's DB9 plug. Pad 3 = ground, DB9 pin 5.

Generated from hardware/design/circuit.py - do not edit by hand
Sheet: /
File: dongle.kicad_sch
Title: WiiM trigger to JBL SA550 RS232 dongle

Size: A3 | Rev: r1 | F Date:
KiCad E.D.A. 10.0.8 | Id: 1/1
