FyrBridd/ext_trigger_jbl_sa550/hardware/dongle/dongle.kicad_pcb

## KiCad design hardware/dongle/dongle.kicad_pcb (2026-11-11)

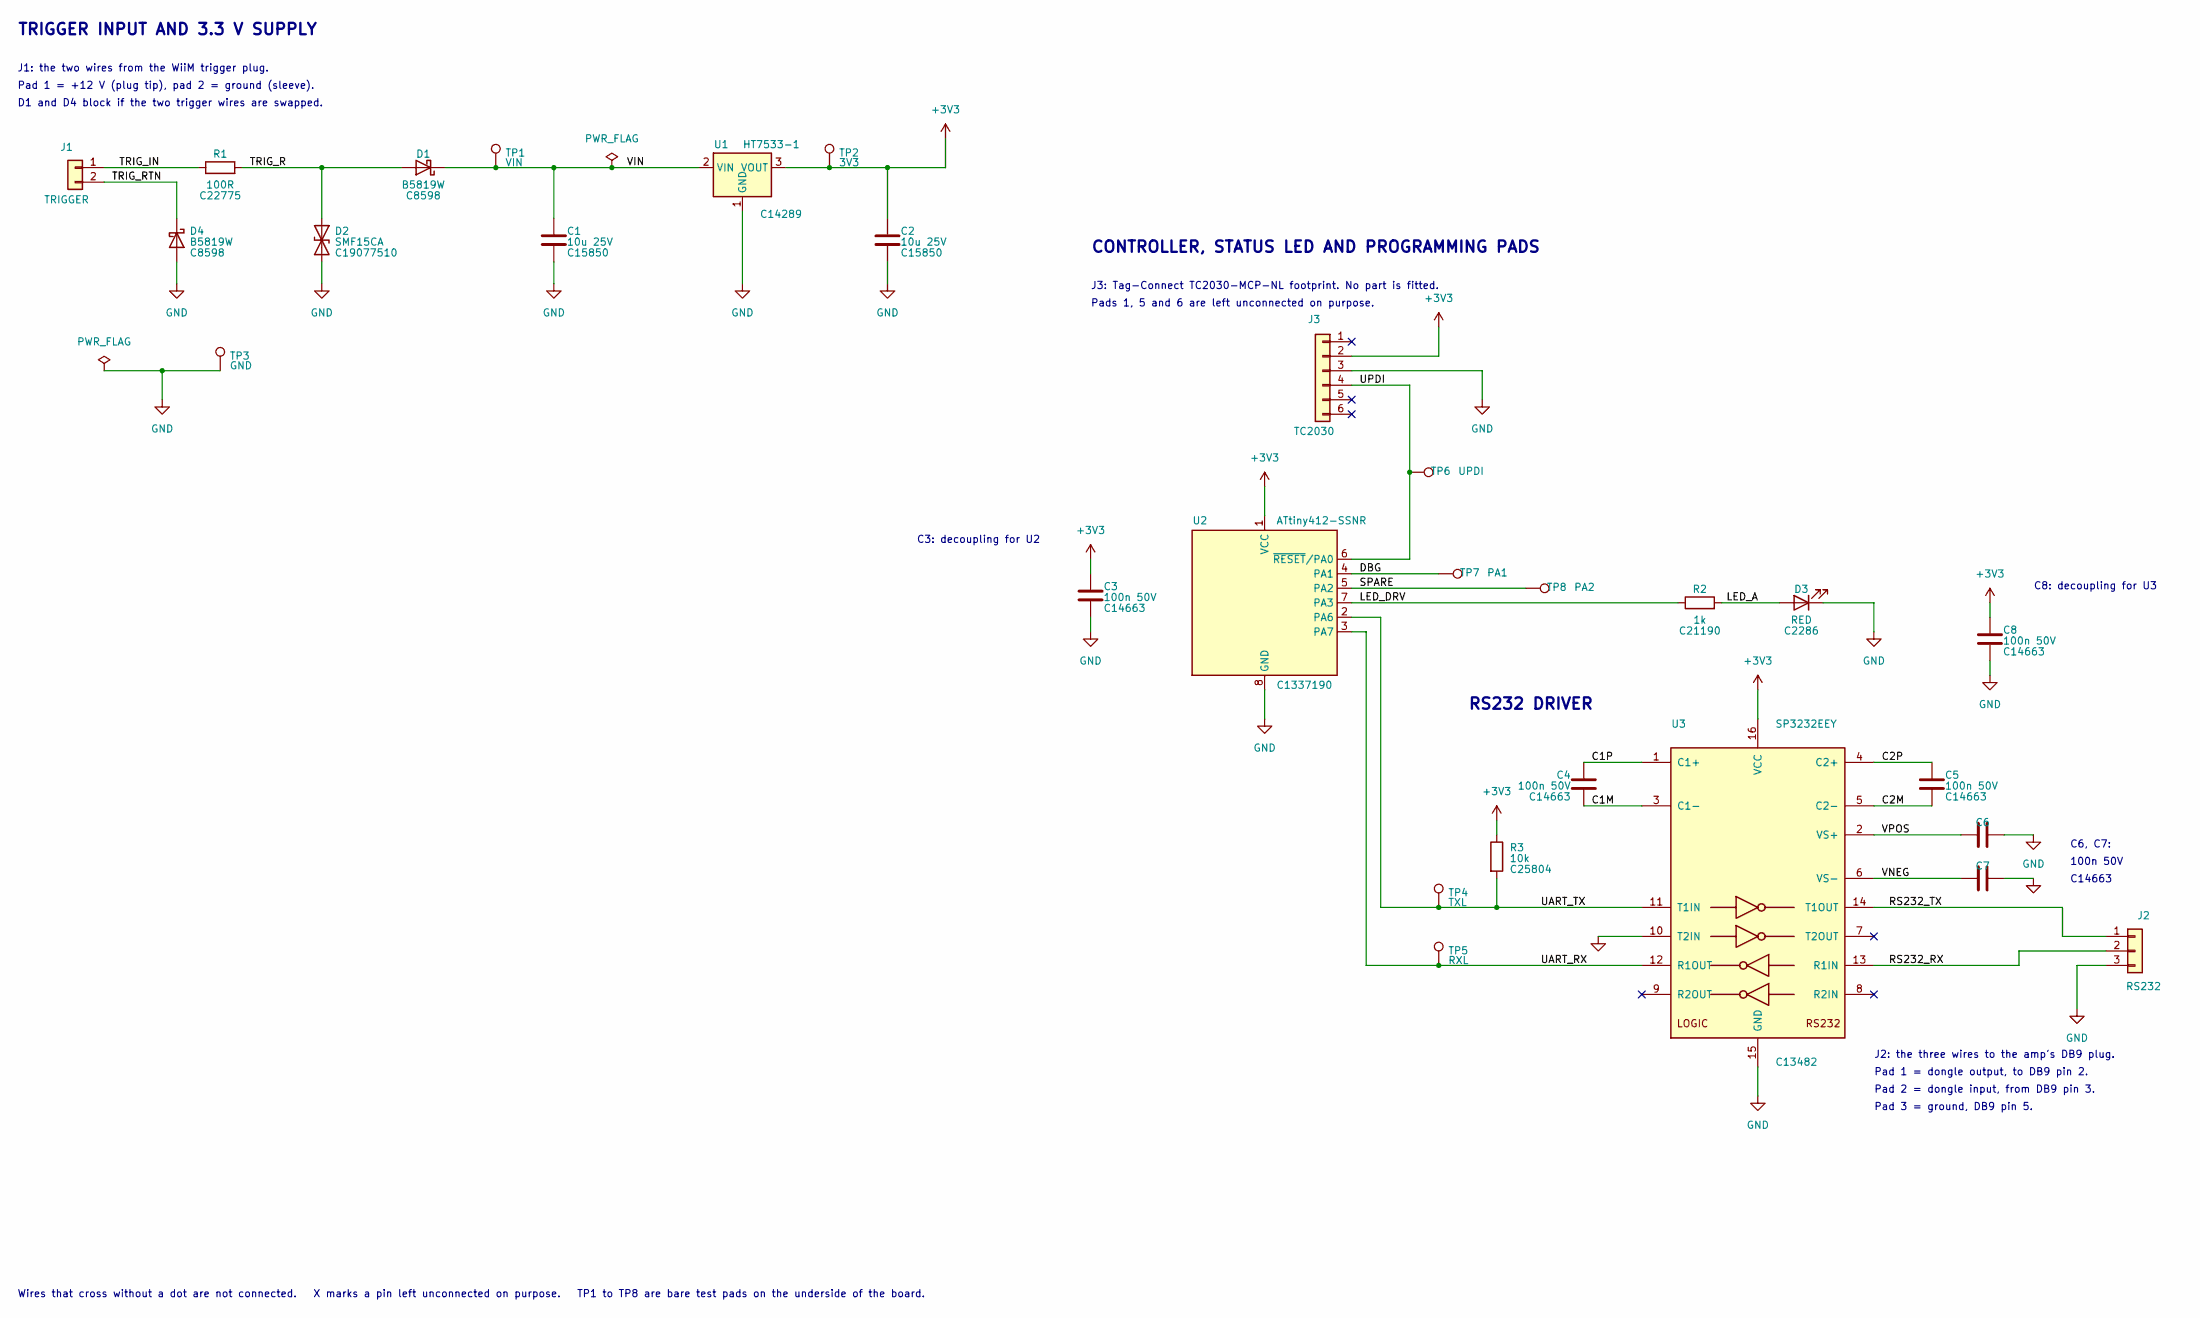
[picture p22: schematic dongle.kicad_sch, WiiM trigger to JBL SA550 RS232 dongle]

Parts:
C1, C2: 10u 25V; C_0805_2012Metric; LCSC C15850
C3, C4, C5, C6, C7, C8: 100n 50V; C_0603_1608Metric; LCSC C14663
D1, D4: B5819W; D_SOD-123; LCSC C8598
D2: SMF15CA; D_SOD-123F; LCSC C19077510
D3: RED; LED_0603_1608Metric; LCSC C2286
J1: TRIGGER; WirePads_1x02_Strain
J2: RS232; WirePads_1x03_Strain
J3: TC2030; TC2030-MCP-NL
R1: 100R; R_0603_1608Metric; LCSC C22775
R2: 1k; R_0603_1608Metric; LCSC C21190
R3: 10k; R_0603_1608Metric; LCSC C25804
TP1: VIN; TestPoint_Pad_D1.0mm
TP2: 3V3; TestPoint_Pad_D1.0mm
TP3: GND; TestPoint_Pad_D1.0mm
TP4: TXL; TestPoint_Pad_D1.0mm
TP5: RXL; TestPoint_Pad_D1.0mm
TP6: UPDI; TestPoint_Pad_D1.0mm
TP7: PA1; TestPoint_Pad_D1.0mm
TP8: PA2; TestPoint_Pad_D1.0mm
U1: HT7533-1; SOT-89-3; LCSC C14289
U2: ATtiny412-SSNR; SOIC-8_3.9x4.9mm_P1.27mm; LCSC C1337190
U3: SP3232EEY; TSSOP-16_4.4x5mm_P0.65mm; LCSC C13482

Connections:
+3V3: C2.1, C3.1, C8.1, J3.2, R3.1, TP2.1, U1.3 (VOUT), U2.1 (VCC), U3.16 (VCC)
/C1M: C4.2, U3.3 (C1-)
/C1P: C4.1, U3.1 (C1+)
/C2M: C5.2, U3.5 (C2-)
/C2P: C5.1, U3.4 (C2+)
/DBG: TP7.1, U2.4 (PA1)
/LED_A: D3.2 (A), R2.2
/LED_DRV: R2.1, U2.7 (PA3)
/RS232_RX: J2.2, U3.13 (R1IN)
/RS232_TX: J2.1, U3.14 (T1OUT)
/SPARE: TP8.1, U2.5 (PA2)
/TRIG_IN: J1.1, R1.1
/TRIG_R: D1.2 (A), D2.1 (A1), R1.2
/TRIG_RTN: D4.1 (K), J1.2
/UART_RX: TP5.1, U2.3 (PA7), U3.12 (R1OUT)
/UART_TX: R3.2, TP4.1, U2.2 (PA6), U3.11 (T1IN)
/UPDI: J3.4, TP6.1, U2.6 (~RESET/PA0)
/VIN: C1.1, D1.1 (K), TP1.1, U1.2 (VIN)
/VNEG: C7.2, U3.6 (VS-)
/VPOS: C6.1, U3.2 (VS+)
GND: C1.2, C2.2, C3.2, C6.2, C7.1, C8.2, D2.2 (A2), D3.1 (K), D4.2 (A), J2.3, J3.3, TP3.1, U1.1 (GND), U2.8 (GND), U3.10 (T2IN), U3.15 (GND)

Notes on the sheet:
TRIGGER INPUT AND 3.3 V SUPPLY
J1: the two wires from the WiiM trigger plug.
Pad 1 = +12 V (plug tip), pad 2 = ground (sleeve).
D1 and D4 block if the two trigger wires are swapped.
CONTROLLER, STATUS LED AND PROGRAMMING PADS
J3: Tag-Connect TC2030-MCP-NL footprint. No part is fitted.
Pads 1, 5 and 6 are left unconnected on purpose.
C3: decoupling for U2
RS232 DRIVER
C8: decoupling for U3
C6, C7:
100n 50V
C14663
J2: the three wires to the amp's DB9 plug.
Pad 1 = dongle output, to DB9 pin 2.
Pad 2 = dongle input, from DB9 pin 3.
Pad 3 = ground, DB9 pin 5.
Wires that cross without a dot are not connected. X marks a pin left unconnected on purpose. TP1 to TP8 are bare test pads on the underside of the board.

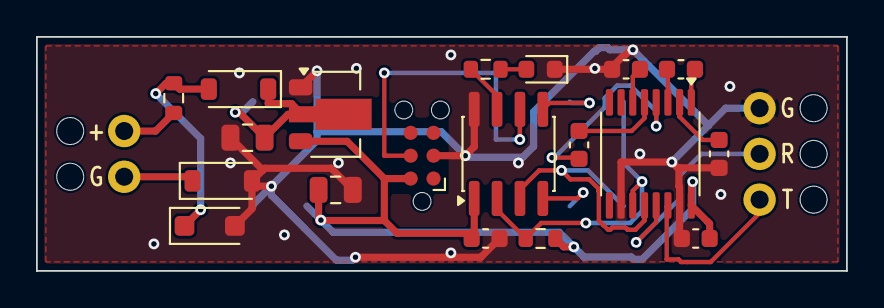
[picture p23: board dongle.kicad_pcb from above]

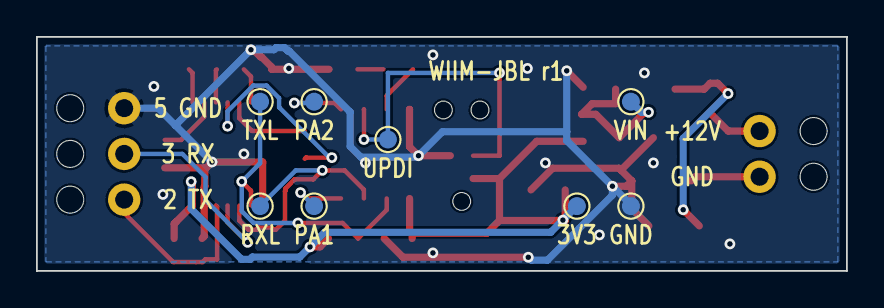
[picture p24: board dongle.kicad_pcb from below]

Board: 2 copper layers, 45.0 x 13.0 mm, 29 parts (8 on the bottom side), 21 nets.
