FyrBridd/ext_trigger_jbl_sa550/(commit log)

2026-11-10 feat(hw): circuit definition
2026-11-10 feat(hw): wire pad and programming footprints
2026-11-10 feat(hw): generated schematic with ERC and netlist checks
    [dongle.kicad_sch]
2026-11-10 feat(hw): board outline and placement
    [dongle.kicad_pcb, dongle.kicad_sch]
2026-11-10 feat(hw): routed board, DRC clean with schematic parity
    [dongle.kicad_pcb, dongle.kicad_sch]
2026-11-10 feat(hw): JLCPCB fabrication outputs
    [bom.csv, dongle.kicad_pcb, dongle.kicad_sch, dongle.step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]
2026-11-10 feat(tools): JLCPCB stock gate
    [dongle.kicad_pcb, dongle.kicad_sch, dongle.step]
2026-11-10 docs(hw): owner review pack, calculations and ordering steps
    [dongle.kicad_pcb, dongle.kicad_sch, dongle.step]
2026-11-10 feat(fw): frame protocol and host test harness
    [dongle.kicad_pcb, dongle.kicad_sch, dongle.step]
2026-11-10 feat(fw): AVR hardware layer, fuses and release hex files
2026-11-10 docs: protocol research, flashing guide and bring-up procedure
    [dongle.kicad_pcb, dongle.kicad_sch, dongle.step]
2026-11-10 fix(fw): bound command rate, accept slow replies, retry refused select; correct review docs
    Findings from the whole-branch review. An amp that acknowledges power-on or
    select with its current state no longer triggers an immediate re-check
    (command storm). Replies are waited for 3 s once the amp is on, 1 s while it
    is waking, and any good 'on' report confirms the amp is on. Builds that never
    query the input no longer take a refused select as done.
    Docs: serial timing margin stated from the datasheet, hole positions table,
    reply-latency step and new fault rows in the bring-up guide.
    [dongle.kicad_pcb, dongle.kicad_sch, dongle.step]
2026-11-10 feat(hw): draw the schematic with wires instead of net labels
    The owner found the label-per-pin schematic very hard to review. The sheet is
    now a conventional drawing: signal flow left to right, parts joined by wires,
    ground and 3.3 V as power symbols, each signal named once on its wire, with
    notes for the three connectors. Connectivity is unchanged; KiCad's netlist of
    the new sheet still equals circuit.py.
    Ground and 3.3 V are now named by power symbols, so the board takes every net
    name from the schematic's netlist and routes.json stores circuit net names.
    Board copper is unchanged.
    [dongle.kicad_pcb, dongle.kicad_sch, dongle.step]
2026-11-10 docs(hw): specify the cables and check the wire holes against them
    The cables to buy were never named, so the wire holes were sized by guess.
    docs/cables.md now names a trigger cable and a serial cable with wire sizes
    from the makers' drawings; hardware/design/cables.py holds the figures and a
    test checks that the strain-relief and solder holes fit them within JLCPCB's
    hole tolerances. The existing 1.5 mm and 1.0 mm holes fit; the board is
    unchanged.
2026-11-10 docs(hw): use the StarTech MXT1001MBK serial cable for the amp end
    The three-core cable recommended before is now sold only in 5 m lengths, so
    the owner chose the ready-made StarTech cable. Its 28 AWG wires fit the
    existing holes (loosely in the solder pads); the board is unchanged. The
    cable's core diameter is a typical figure, not a published one, and the
    bring-up guide now has it measured before soldering.
2026-11-11 feat(hw): add D4 so swapped trigger wires cannot short the WiiM
    D1 alone protected the dongle from swapped trigger wires, but not the WiiM:
    the swapped +12 V wire landed on board ground, which is shared with the amp
    and, through the audio cable, with the WiiM, shorting its trigger output.
    D4, a second B5819W, now sits in the trigger's return wire (cathode to the
    ground pad, anode to board ground). With both diodes neither wire has a path
    to anything when swapped. The new TRIG_RTN net is routed at power width; the
    board is re-routed and still 13 x 45 mm.
    Calculations, review pack, bring-up guide and design document updated,
    including the cost: the dongle's return current now takes the groun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
    [bom.csv, dongle.kicad_pcb, dongle.kicad_sch, dongle.step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]
2026-11-11 docs: enclosure implementation plan
2026-11-11 feat(enc): enclosure parameters from the board and cable data
2026-11-11 docs(enc): screw specification
    Names the screw and sizes the shell to it: a wider counterbore so a PZ1
    driver's blade fits, and a relieved mouth on each pilot hole.
2026-11-11 feat(enc): STEP, STL, pictures and drawing
    Also opens the outer side of each screw-head recess where the wall beside
    it would taper below JLC3DP's 1.2 mm minimum.
    [lower.step, lower.stl, upper.step, upper.stl]
2026-11-11 docs(enc): enclosure review, ordering and assembly
2026-11-11 fix(enc): key the lid, deepen the pilot holes, tighten checks, correct the review pack
    From the final review:
    - the trigger end is 2 mm longer, so the lid's screw holes line up only
    one way round
    - pilot holes 6 mm deep, so a screw cannot bottom out
    - the volume check is held to 0.5 mm3, not 0.5 %
    - the review pack states the wall round each part of a screw bore as it
    is, and no longer says the lid is keyed by the collars
    - the core length to leave when soldering is given in bring-up.md and
    cables.md, and checked against the collars
    [lower.step, lower.stl, upper.step, upper.stl]
